JRavenelco/WRO_2025_SSbots/Engineering_Journal/August/IMG_20250806_161136889.jpg

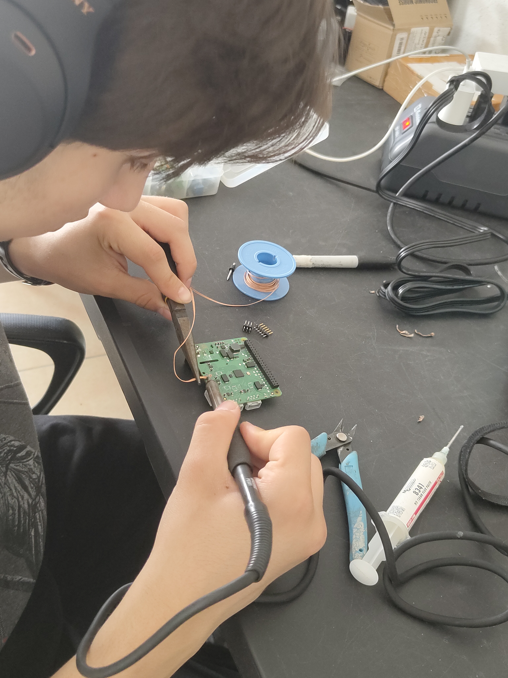
Engineering_Journal/August/IMG_20250806_161136889.jpg
