JRavenelco/WRO_2025_SSbots/models/README.md

# Models

This folder contains the various 3D printing files and models of the Robot LEGO chassis design. The design process and usage of these parts are documented in the [Hardware documentation](https://github.com/JRavenelco/WRO_2025_SSbots/tree/main/Engineering_Journal).
