JRavenelco/WRO_2025_SSbots/oak/README.md

This file contains the dataset used by the team to train the model for the camera to detect the various obstacles the robot will confront during the 2nd challenge.
