JRavenelco/WRO_2025_SSbots/lidar/README.md

This file contains usefull tools related to the LiDAR, this helped us a lot through the proccess of programming our robot.
