JRavenelco/WRO_2025_SSbots/v-photos/Render/README.md

# Vehicle's photos

This folder contains Renders of the CAD models and pictures of the current iteration of the robot, one from each direction, and its Hardware components.
