JRavenelco/WRO_2025_SSbots/videos/README.md

# Test and development videos

This folder contains videos of performance tests and of some of the development activities.

## SSbots reto 1 16 de septiembre 2025
Mira el Short (https://www.youtube.com/shorts/EhMzD_oaSlY)

## SSbots 15 de septiembre 2025
Mira el Short (https://www.youtube.com/shorts/7kQmQHDEUo0)

## 14 de septiembre SSbots 2025
Mira el Short (https://www.youtube.com/shorts/f8a6-zWJJuc)

## 11 de septiembre SSBots 2025
Mira el Short (https://www.youtube.com/shorts/gj_roj9W8ns)

## 18 de septiembre SSBOTS 2025
Mira el Short (https://www.youtube.com/shorts/k6APh_VoyJg)
