JRavenelco/WRO_2025_SSbots/other/Power delivery board/Power delivery Architecture.png

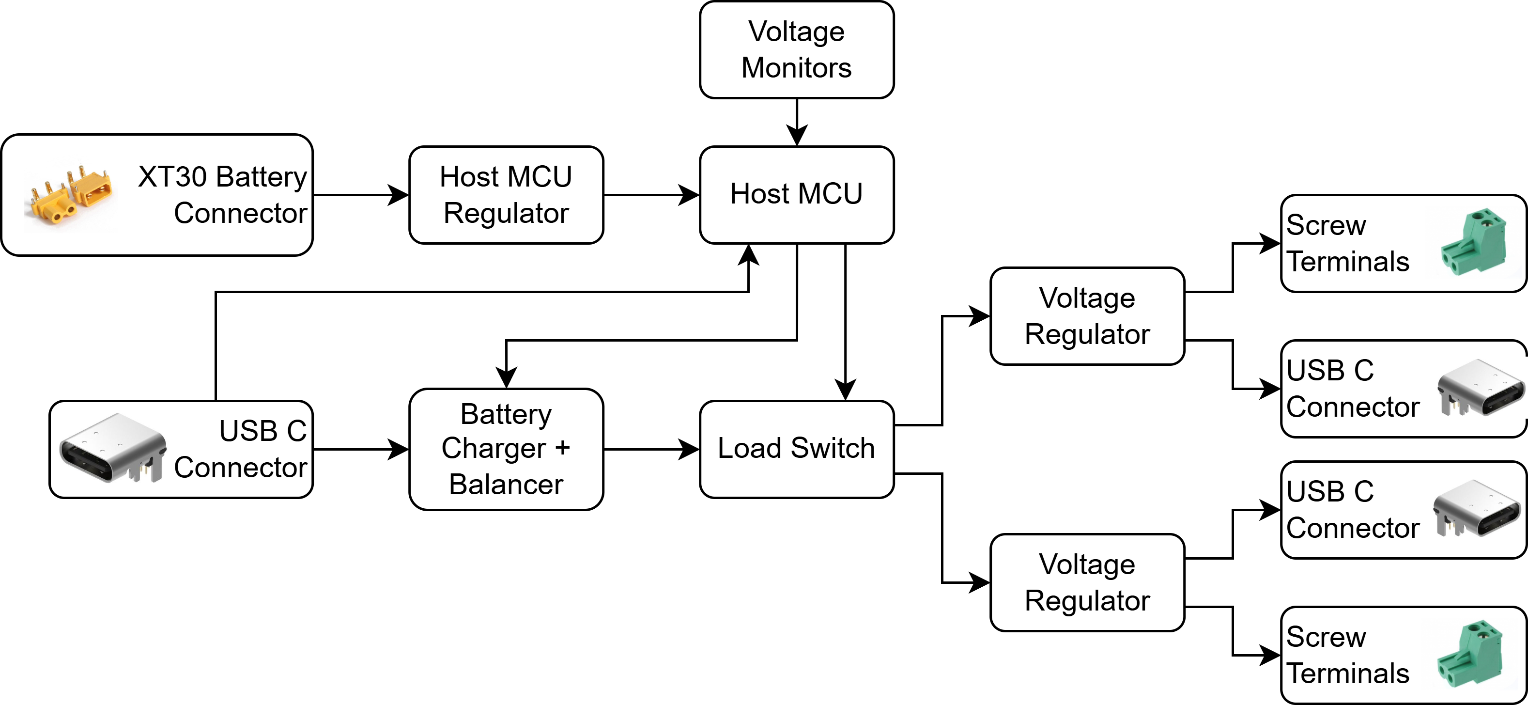
other/Power delivery board/Power delivery Architecture.png
