JRavenelco/WRO_2025_SSbots/other/Power Regulator Input.png

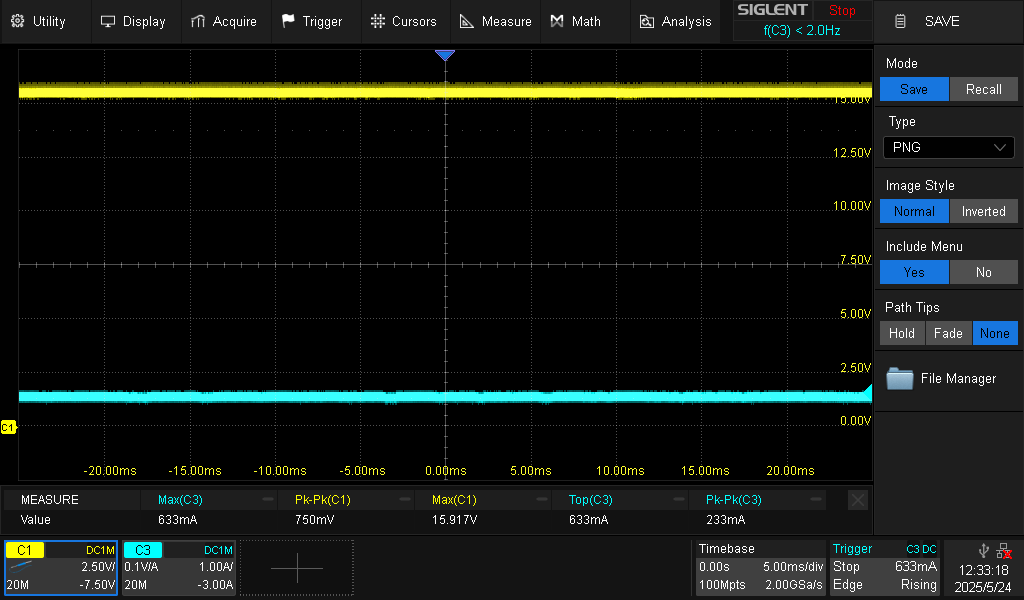
other/Power Regulator Input.png
