JRavenelco/WRO_2025_SSbots/other/Power Regulator Output.png

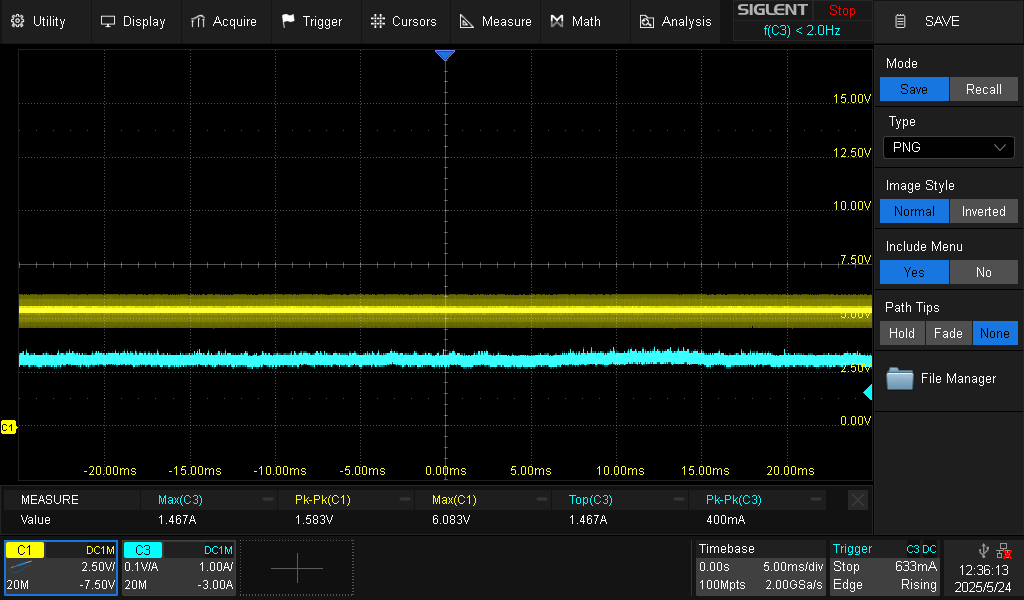
other/Power Regulator Output.png
