JRavenelco/WRO_2025_SSbots/t-photos/IMG_20250531_133741946.jpg

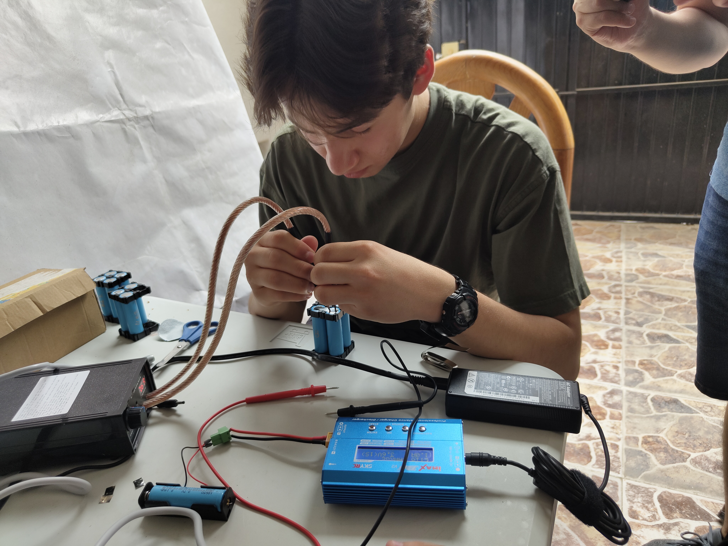
t-photos/IMG_20250531_133741946.jpg
