JRavenelco/WRO_2025_SSbots/v-photos/Back.jpg

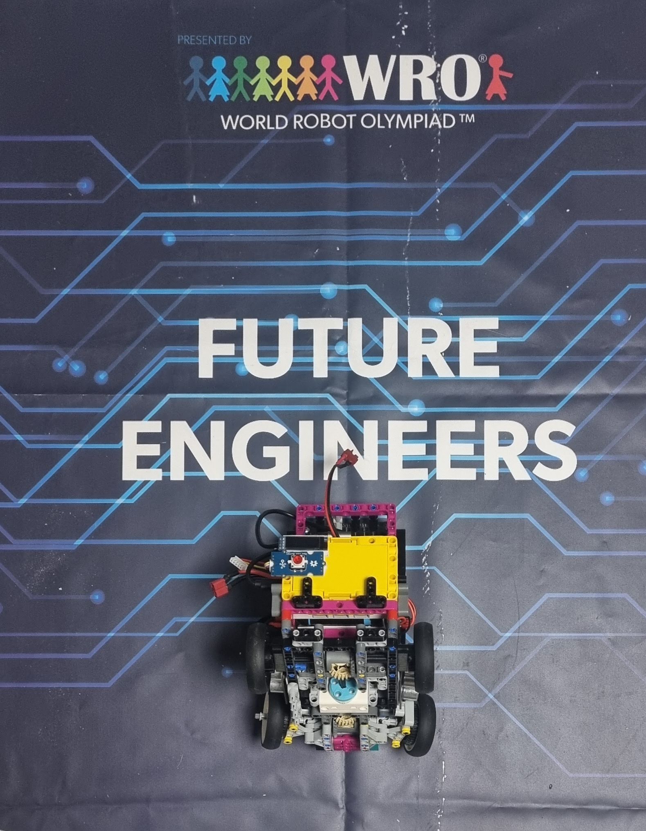
v-photos/Back.jpg
