JRavenelco/WRO_2025_SSbots/v-photos/Bottom.jpg

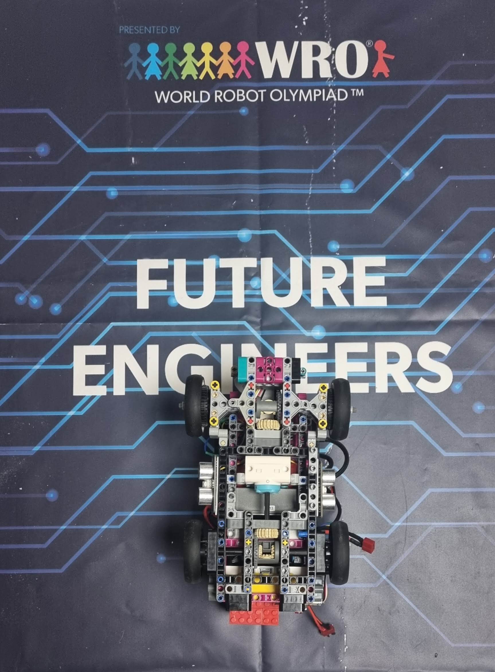
v-photos/Bottom.jpg
