JRavenelco/WRO_2025_SSbots/v-photos/Front.jpg

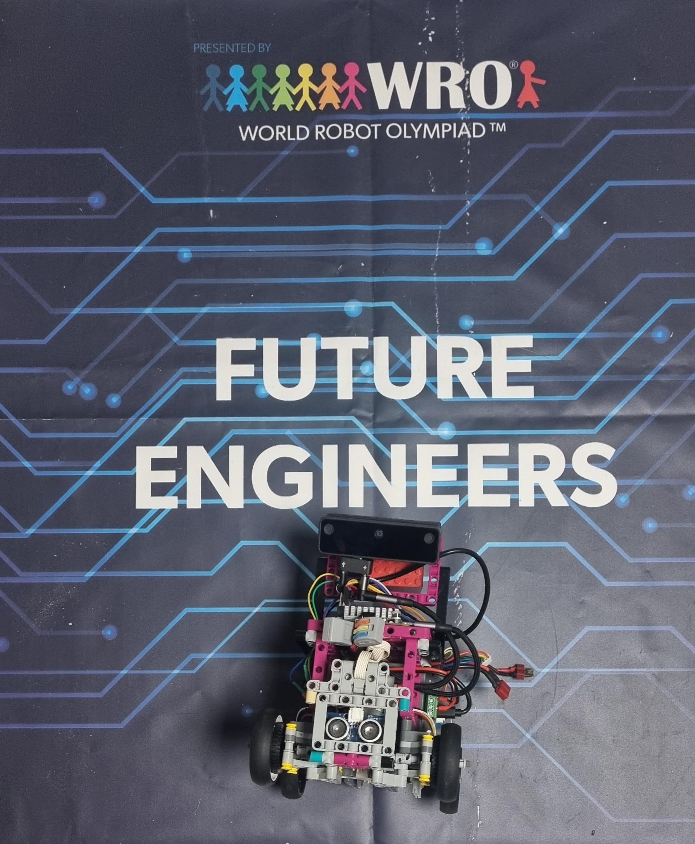
v-photos/Front.jpg
