JRavenelco/WRO_2025_SSbots/v-photos/Left.jpg

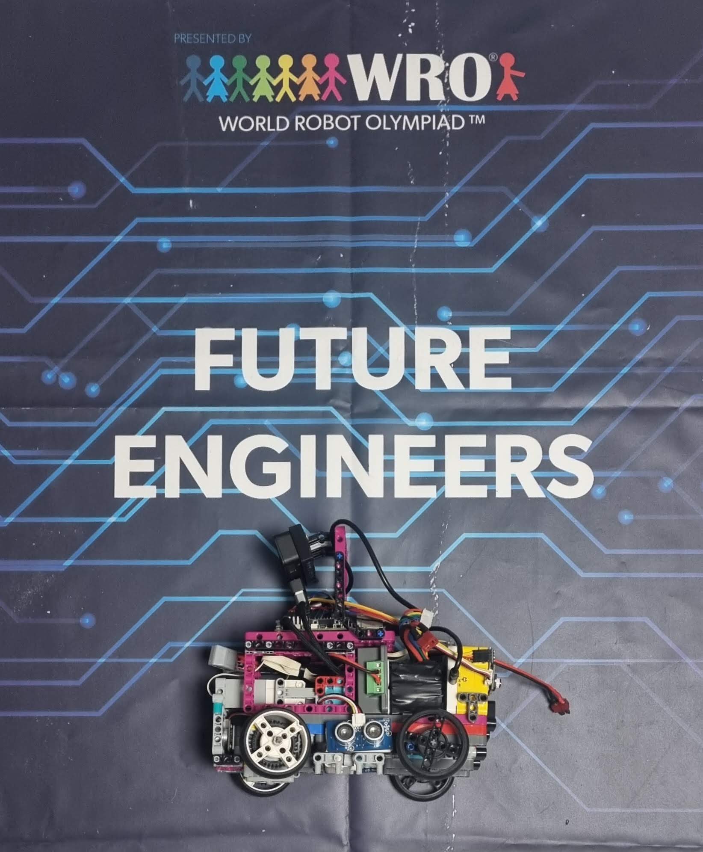
v-photos/Left.jpg
