JRavenelco/WRO_2025_SSbots/v-photos/Render/Back.png

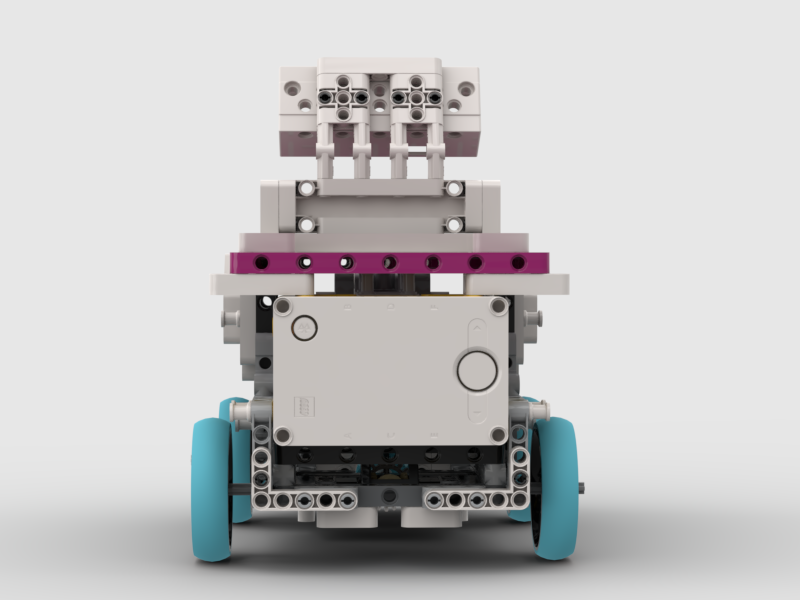
v-photos/Render/Back.png
