JRavenelco/WRO_2025_SSbots/v-photos/Render/Bottom.png

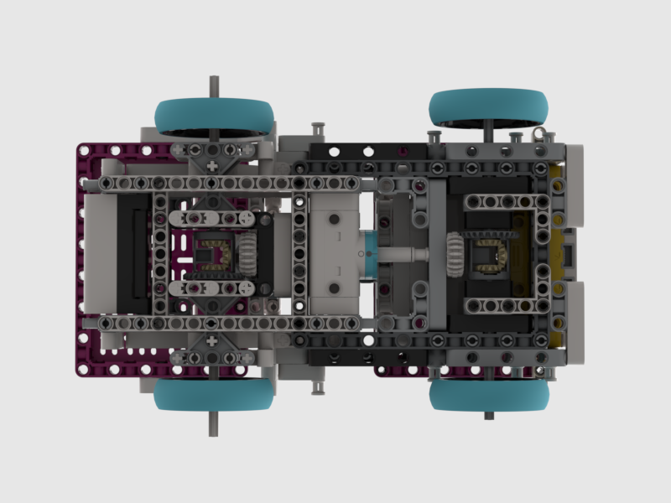
v-photos/Render/Bottom.png
