JRavenelco/WRO_2025_SSbots/v-photos/Render/Front.png

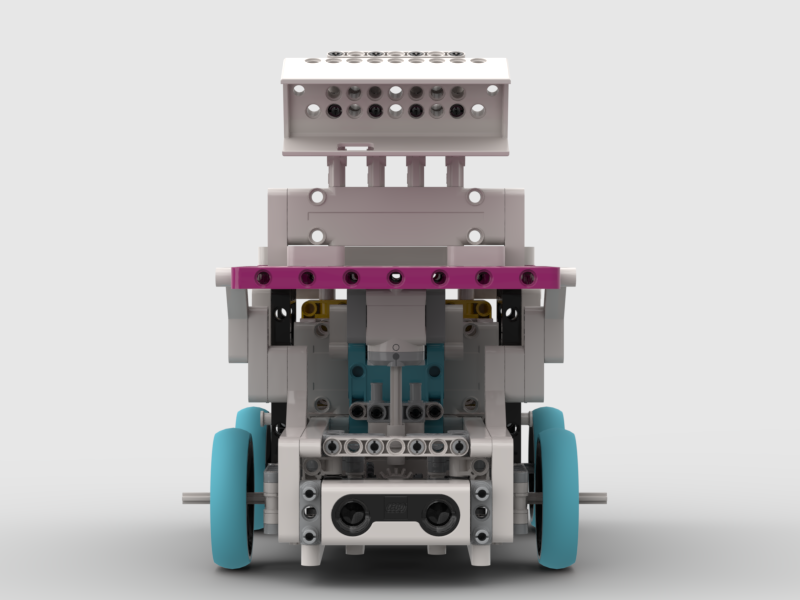
v-photos/Render/Front.png
