JRavenelco/WRO_2025_SSbots/v-photos/Render/Isometric.png

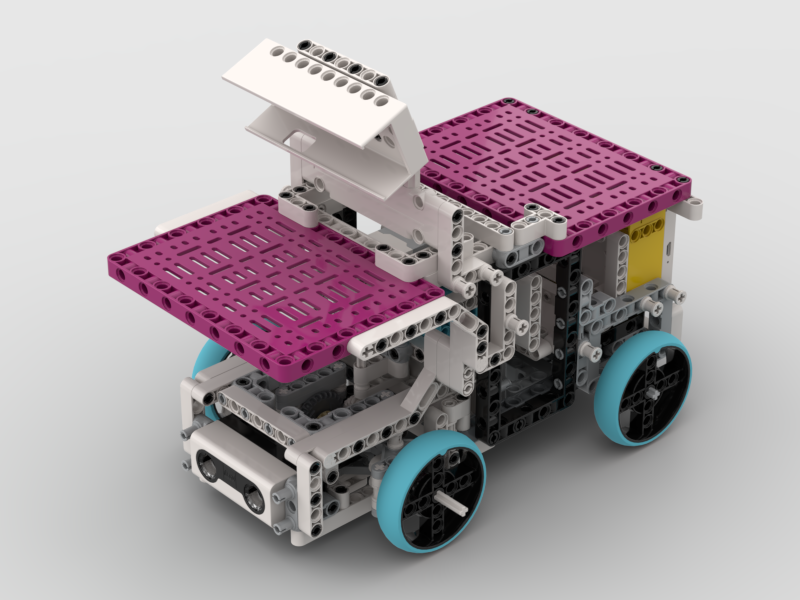
v-photos/Render/Isometric.png
