JRavenelco/WRO_2025_SSbots/v-photos/Render/Left.png

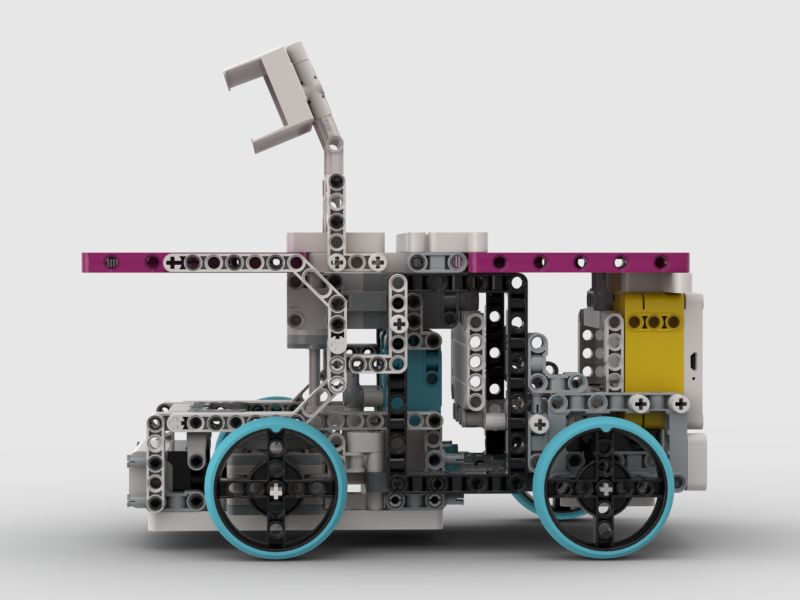
v-photos/Render/Left.png
