JRavenelco/WRO_2025_SSbots/v-photos/Render/Right.png

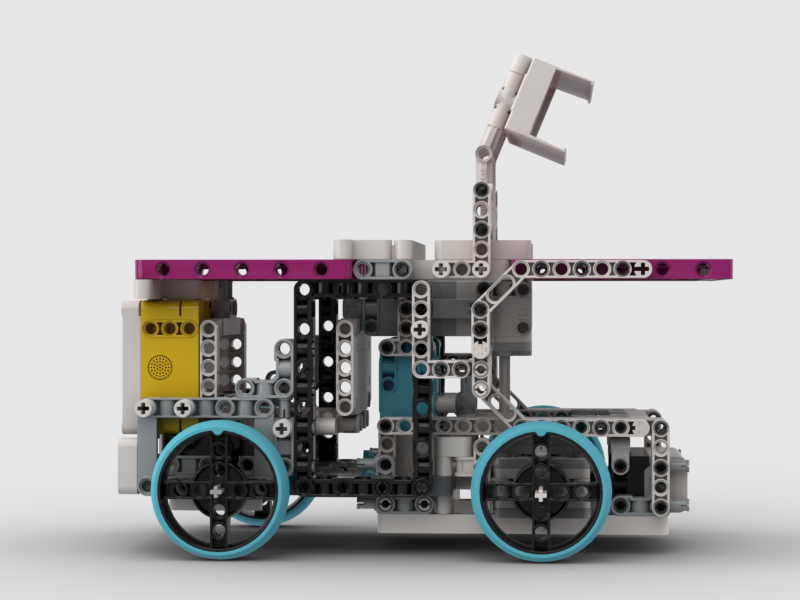
v-photos/Render/Right.png
