JRavenelco/WRO_2025_SSbots/v-photos/Render/Top.png

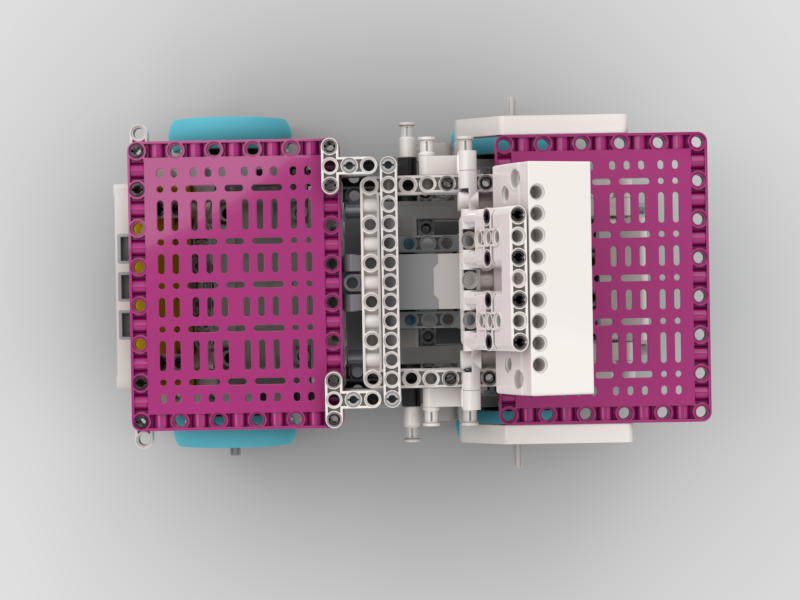
v-photos/Render/Top.png
