JRavenelco/WRO_2025_SSbots/v-photos/Right.jpg

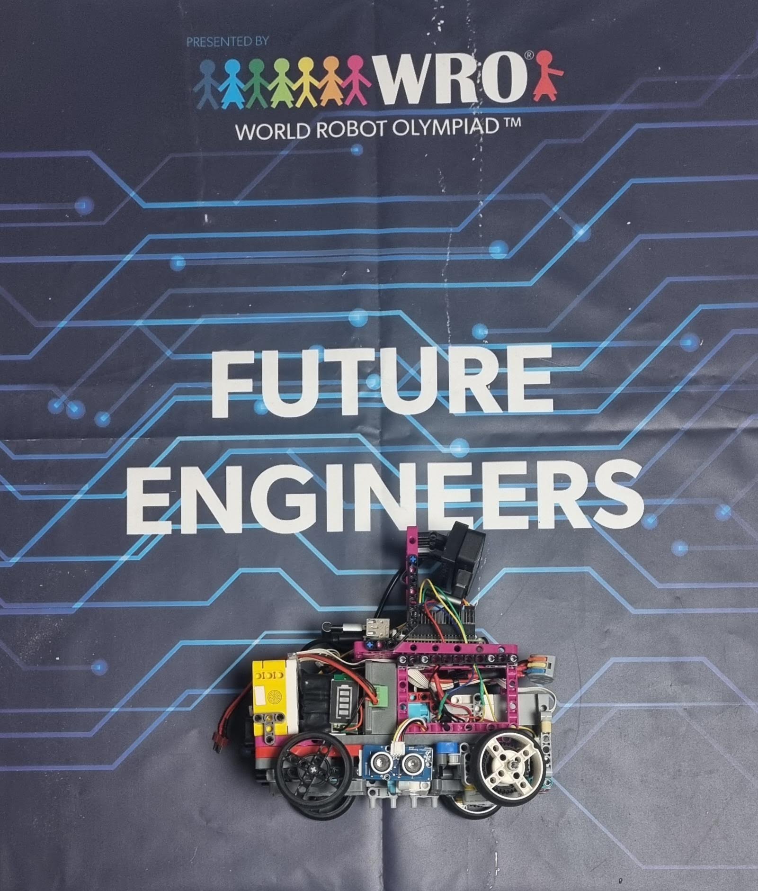
v-photos/Right.jpg
