JRavenelco/WRO_2025_SSbots/v-photos/Robot Nationals Ver (4).jpg

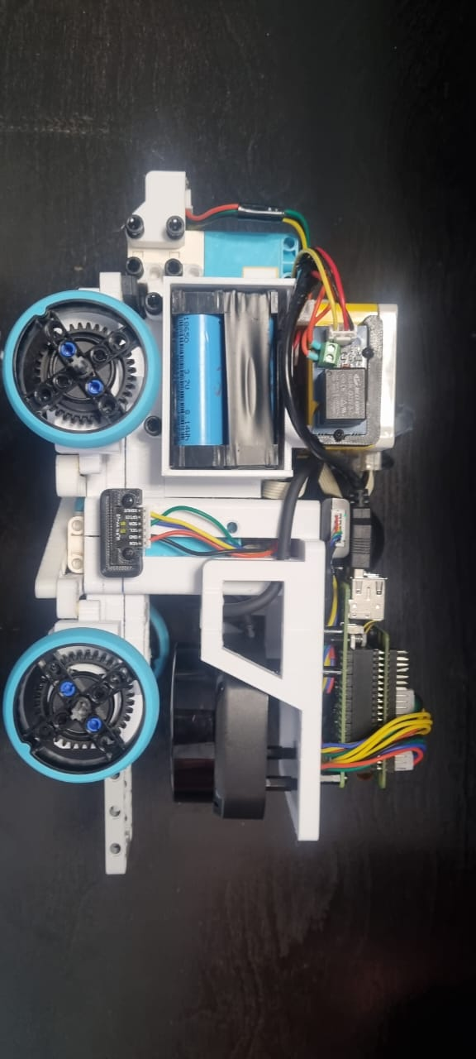
v-photos/Robot Nationals Ver (4).jpg
