JRavenelco/WRO_2025_SSbots/v-photos/Robot Nationals Ver (5).jpg

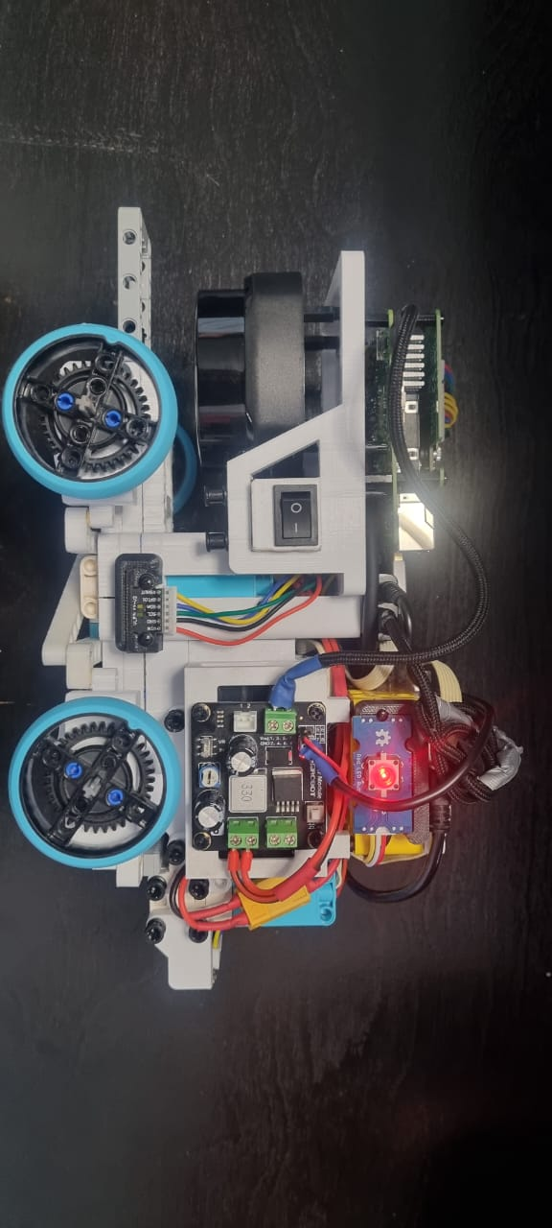
v-photos/Robot Nationals Ver (5).jpg
