JRavenelco/WRO_2025_SSbots/v-photos/Robot Nationals Ver (6).jpg

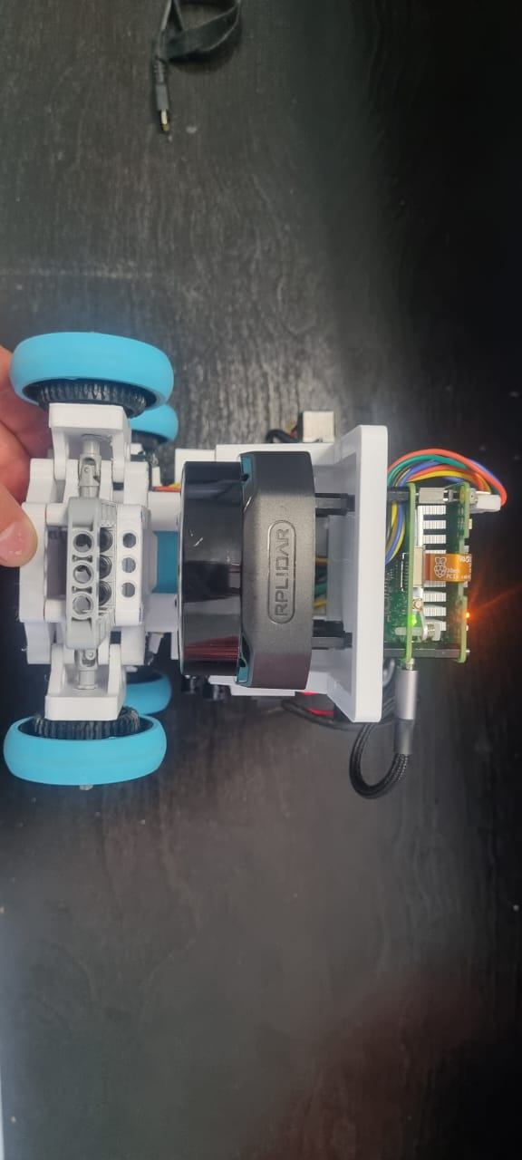
v-photos/Robot Nationals Ver (6).jpg
