JRavenelco/WRO_2025_SSbots/v-photos/Top.jpg

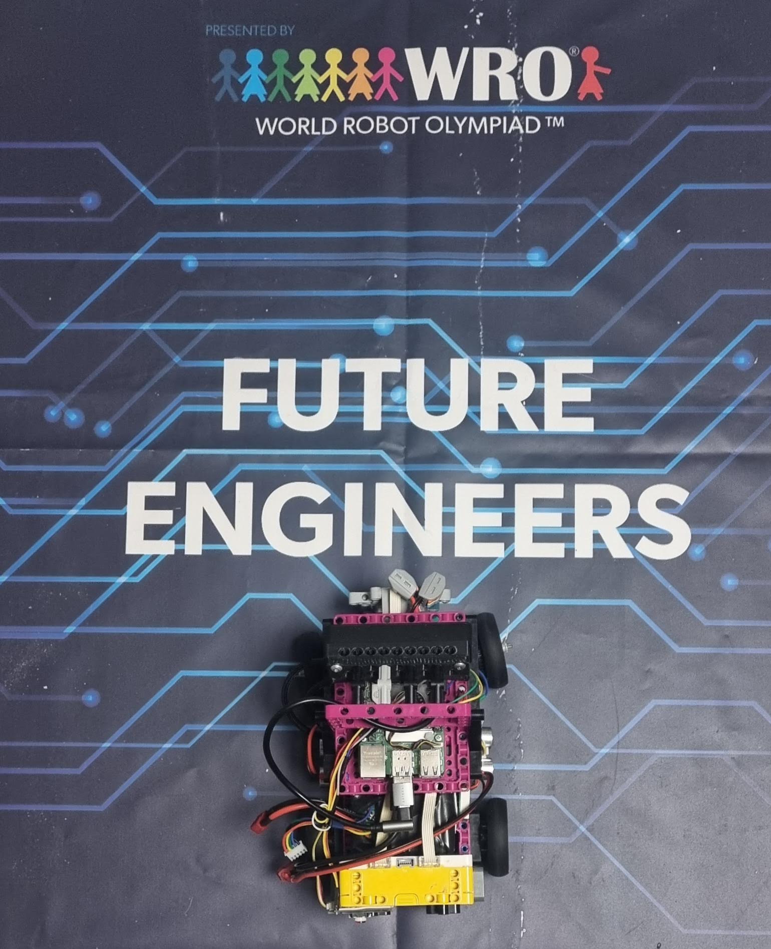
v-photos/Top.jpg
