JRavenelco/WRO_2025_SSbots/Engineering_Journal/August/Viga_LiDAR_prueba1.stl

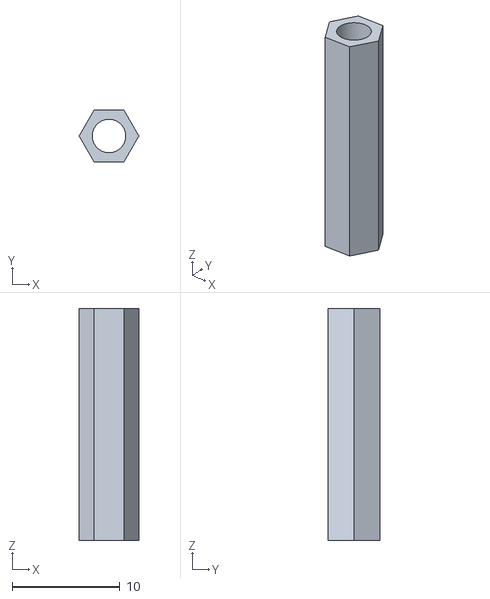
[picture p26: CAD file, 2025-08-16]
Engineering_Journal/August/Viga_LiDAR_prueba1.stl
5.54 x 4.80 x 21.5
