JRavenelco/WRO_2025_SSbots/models/beam_12_jellyfish.stl

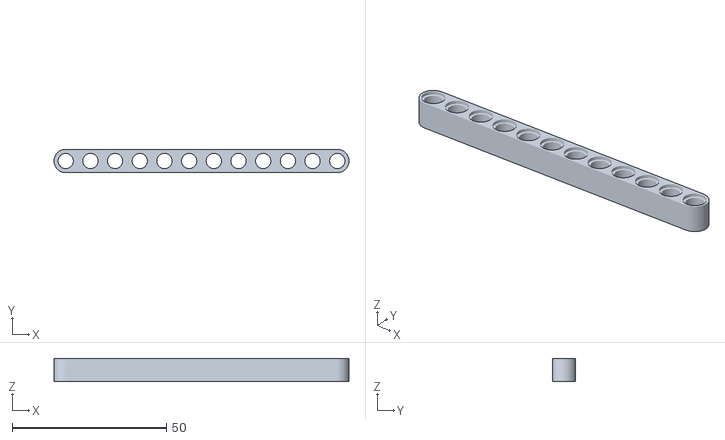
[picture p27: CAD file, 2025-09-17]
models/beam_12_jellyfish.stl
95.6 x 7.60 x 7.60
