JRavenelco/WRO_2025_SSbots/Engineering_Journal/August/Enclosure_pilas_-peso.stl

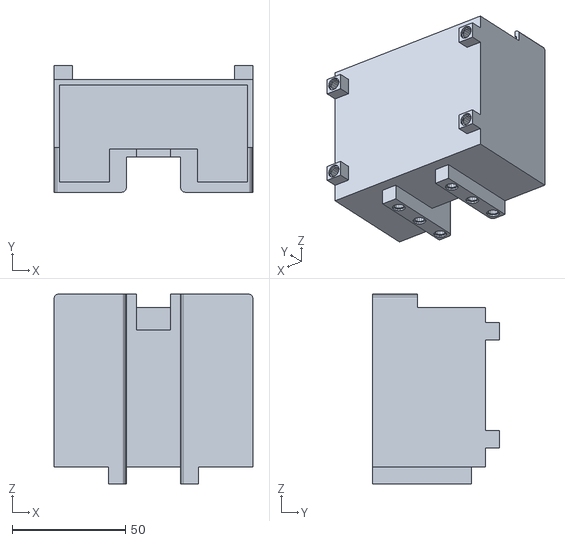
[picture p28: CAD file, 2025-08-16]
Engineering_Journal/August/Enclosure_pilas_-peso.stl
88.0 x 56.0 x 84.0
