JRavenelco/WRO_2025_SSbots/models/robot_rear_base_jellyfish.stl

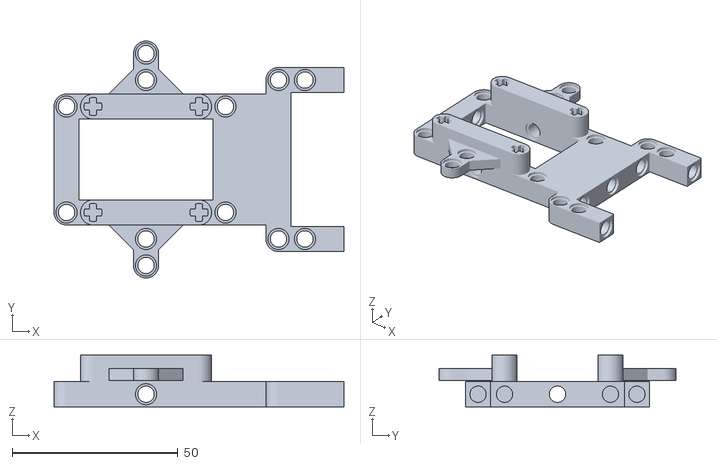
[picture p29: CAD file, 2025-09-17]
models/robot_rear_base_jellyfish.stl
87.6 x 71.6 x 15.6
