JRavenelco/WRO_2025_SSbots/Engineering_Journal/August/Base_sensor_atrás_prueba1.stl

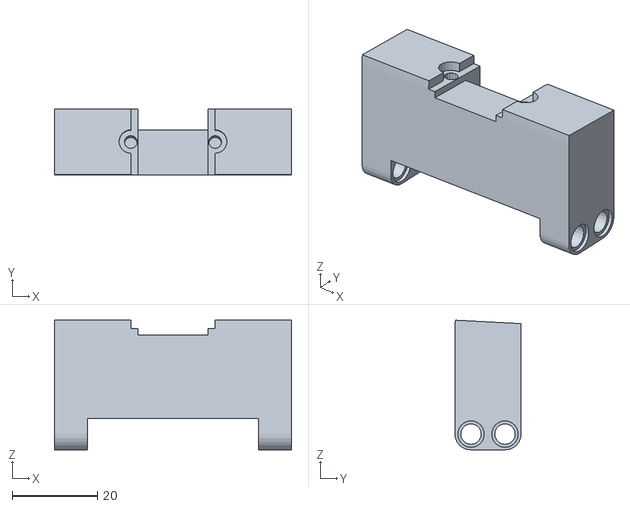
[picture p30: CAD file, 2025-08-12]
Engineering_Journal/August/Base_sensor_atrás_prueba1.stl
55.5 x 15.5 x 30.4
