JRavenelco/WRO_2025_SSbots/models/motor_chasis_jellyfish.stl

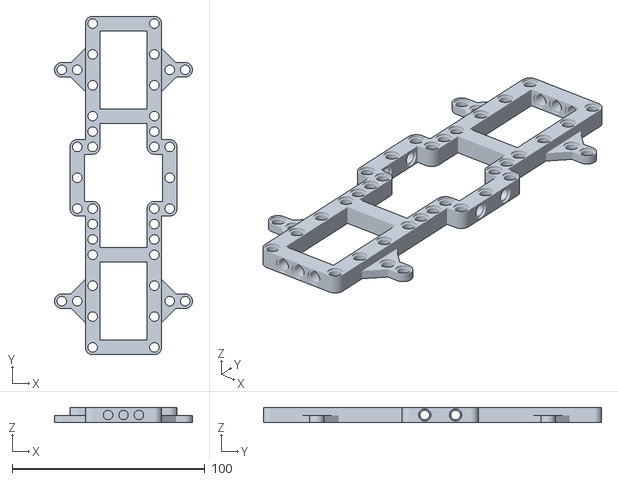
[picture p31: CAD file, 2025-09-17]
models/motor_chasis_jellyfish.stl
71.6 x 175.6 x 7.60
