JRavenelco/WRO_2025_SSbots/Engineering_Journal/August/Base_sensor_lateral_2.0_prueba2.stl

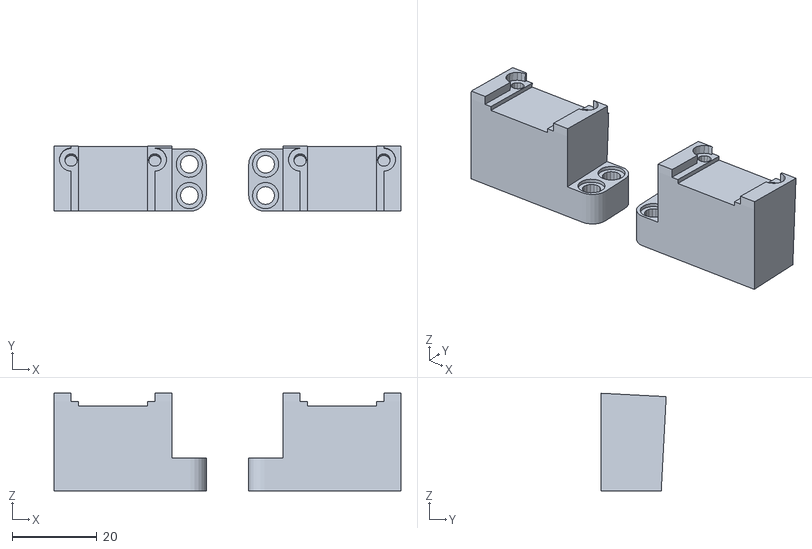
[picture p32: CAD file, 2025-08-12]
Engineering_Journal/August/Base_sensor_lateral_2.0_prueba2.stl
81.8 x 15.4 x 23.0
