JRavenelco/WRO_2025_SSbots/models/beam_11x2_jellyfish.stl

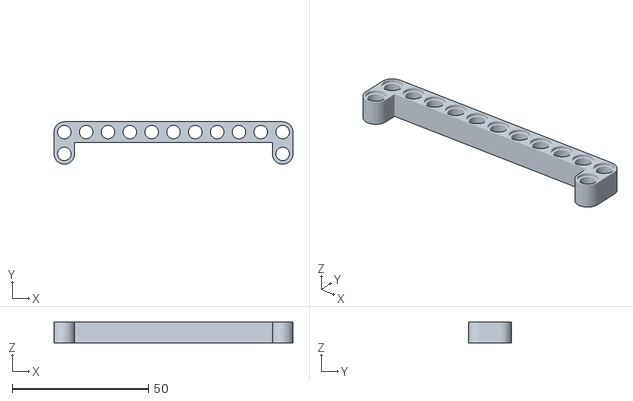
[picture p33: CAD file, 2025-09-17]
models/beam_11x2_jellyfish.stl
87.6 x 15.6 x 7.60
