JRavenelco/WRO_2025_SSbots/Engineering_Journal/August/Enclosure_pilas_3.0.stl

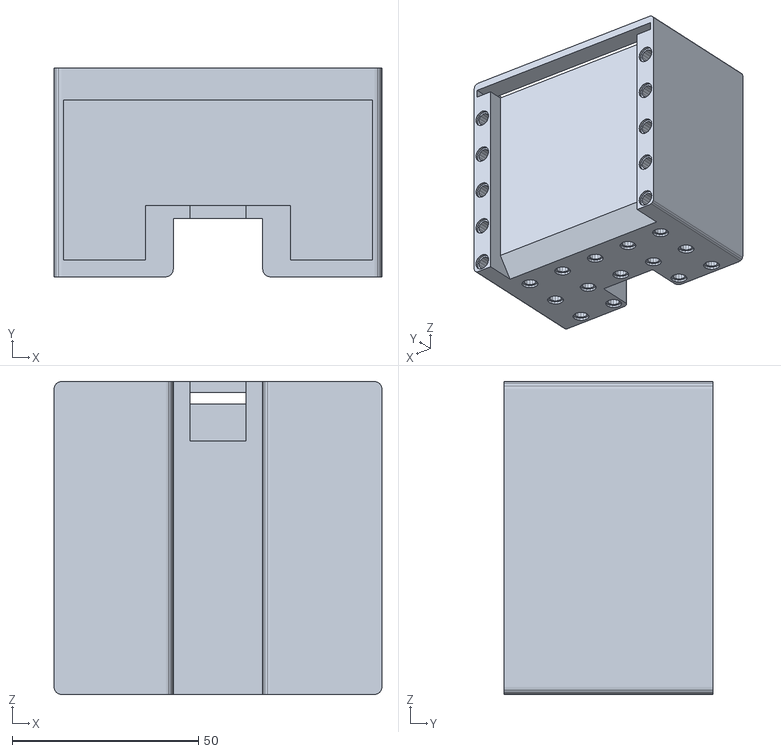
[picture p34: CAD file, 2025-08-12]
Engineering_Journal/August/Enclosure_pilas_3.0.stl
88.0 x 56.0 x 84.0
