JRavenelco/WRO_2025_SSbots/models/axle_support_rear_jellyfish.stl

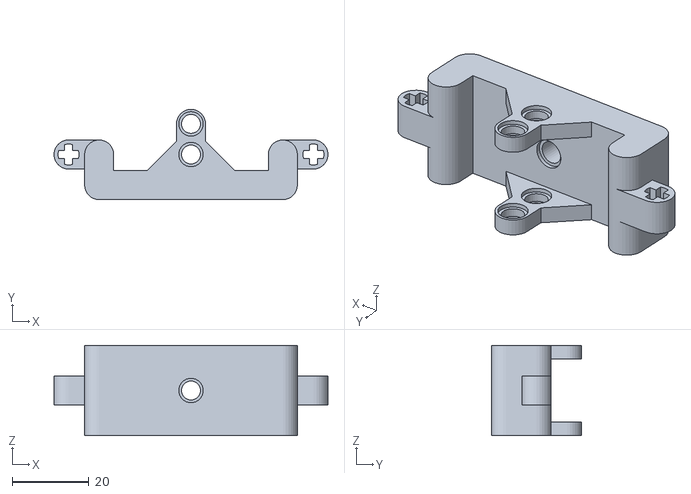
[picture p35: CAD file, 2025-09-17]
models/axle_support_rear_jellyfish.stl
71.6 x 23.6 x 23.6
