JRavenelco/WRO_2025_SSbots/Engineering_Journal/August/Tapa_enclosure_pilas_2.0.stl

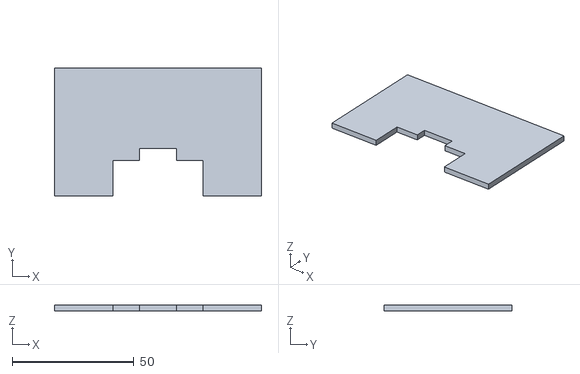
[picture p36: CAD file, 2025-08-07]
Engineering_Journal/August/Tapa_enclosure_pilas_2.0.stl
85.0 x 52.5 x 2.50
