JRavenelco/WRO_2025_SSbots/models/gearRack_beam_jellyfish.stl

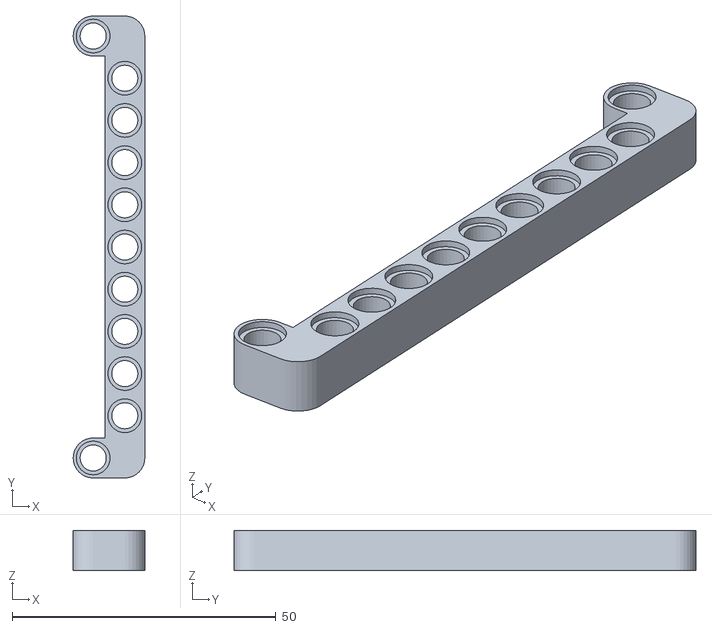
[picture p37: CAD file, 2025-09-17]
models/gearRack_beam_jellyfish.stl
13.6 x 87.6 x 7.60
