JRavenelco/WRO_2025_SSbots/Engineering_Journal/August/Enclosure_pilas.stl

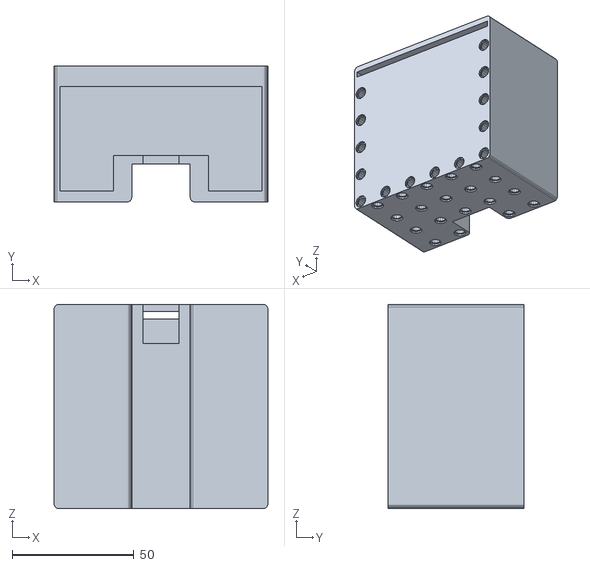
[picture p38: CAD file, 2025-08-07]
Engineering_Journal/August/Enclosure_pilas.stl
88.0 x 56.0 x 84.0
