JRavenelco/WRO_2025_SSbots/models/axle_support_front_jellyfish.stl

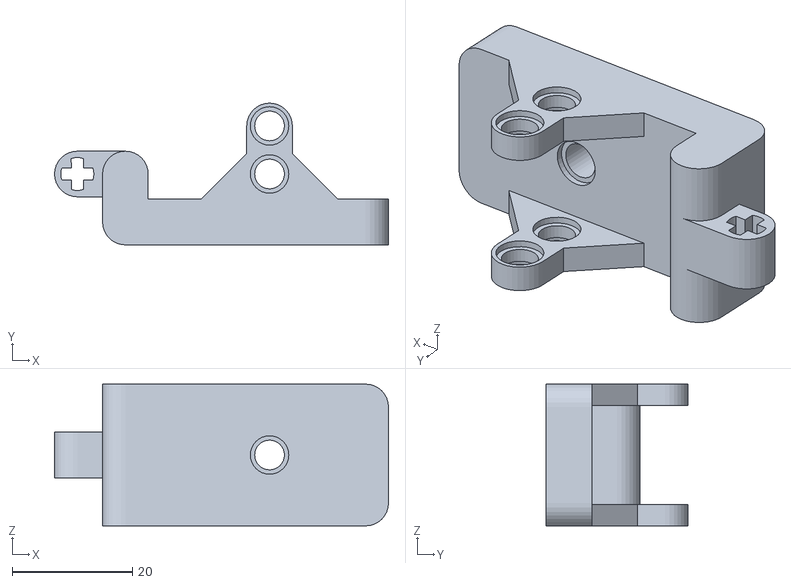
[picture p39: CAD file, 2025-09-17]
models/axle_support_front_jellyfish.stl
55.6 x 23.6 x 23.6
