JRavenelco/WRO_2025_SSbots/models/monstrosity_jellyfish.stl

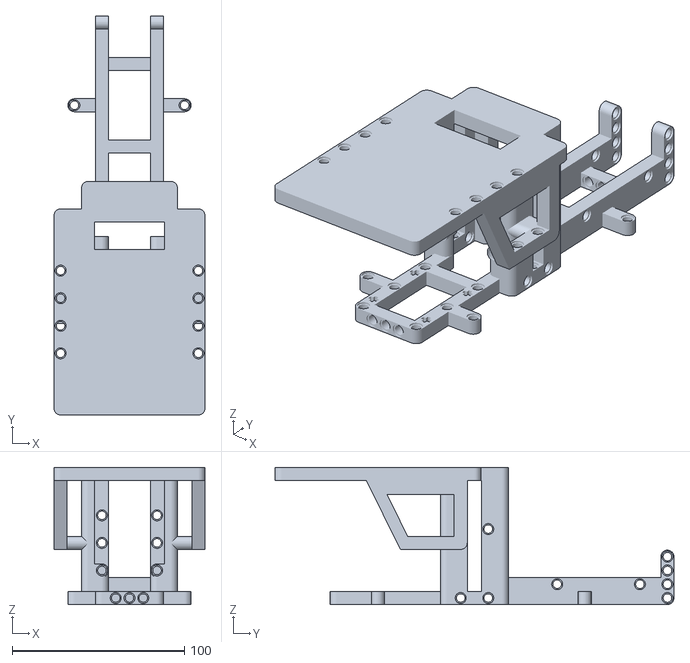
[picture p40: CAD file, 2025-09-17]
models/monstrosity_jellyfish.stl
87.6 x 231.6 x 79.6
