JRavenelco/WRO_2025_SSbots/models/backSensor_jellyfish.stl

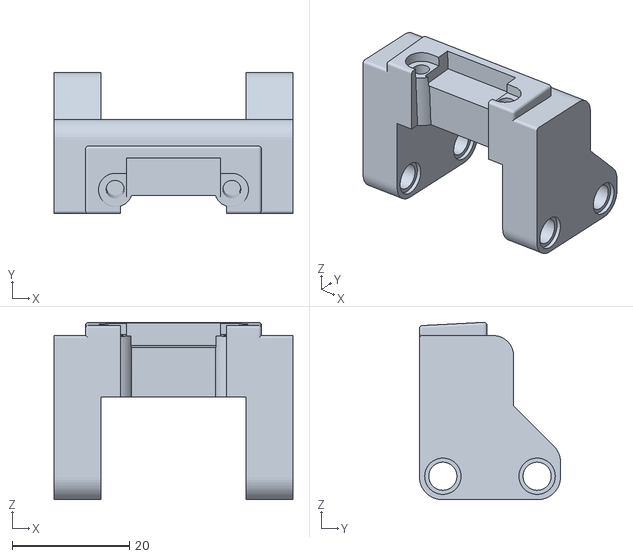
[picture p41: CAD file, 2025-09-17]
models/backSensor_jellyfish.stl
40.8 x 24.1 x 30.3
