JRavenelco/WRO_2025_SSbots/models/tapa_enclosure_jellyfish.stl

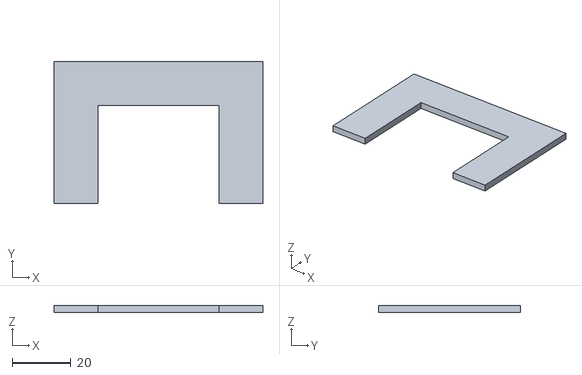
[picture p42: CAD file, 2025-09-17]
models/tapa_enclosure_jellyfish.stl
71.0 x 48.4 x 2.50
