JRavenelco/WRO_2025_SSbots/models/enclosure_pilas_jellyfish.stl

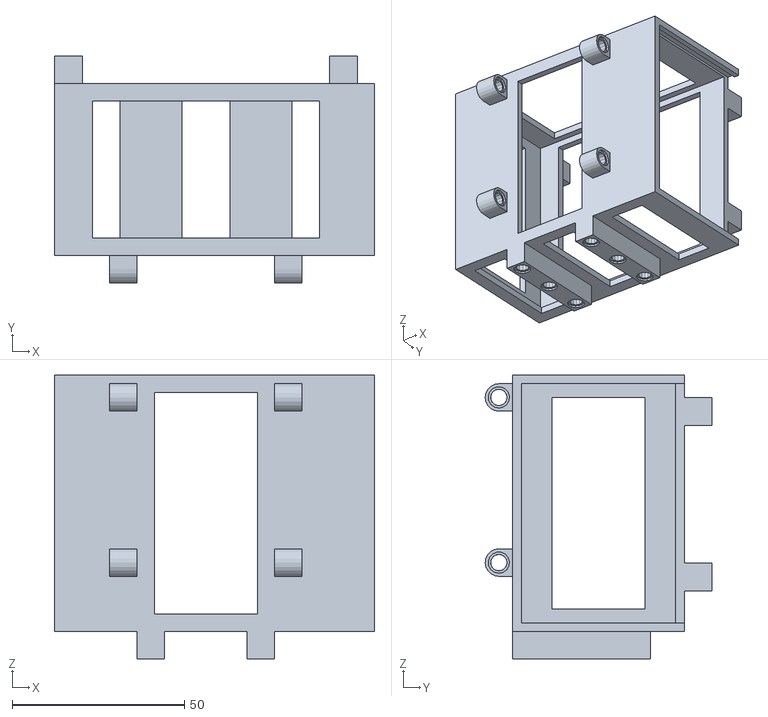
[picture p43: CAD file, 2025-09-17]
models/enclosure_pilas_jellyfish.stl
93.0 x 65.9 x 82.5
