JRavenelco/WRO_2025_SSbots/models/grooveBase_B_jellyfish.stl

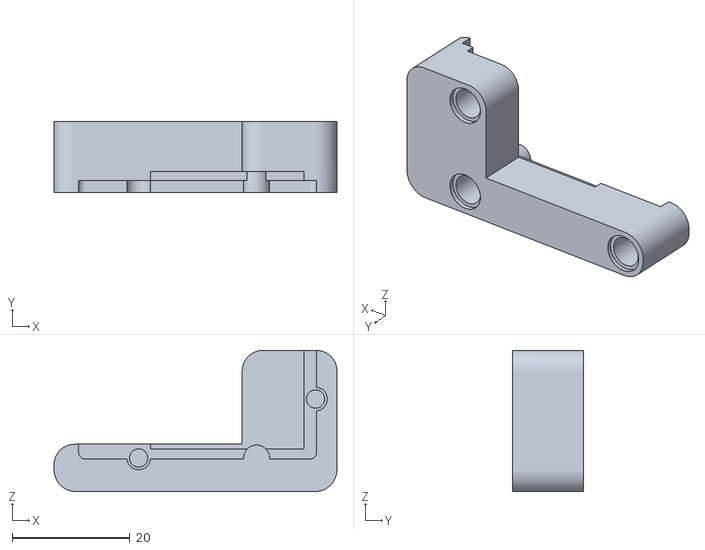
[picture p44: CAD file, 2025-08-16]
models/grooveBase_B_jellyfish.stl
48.0 x 12.0 x 24.0
