JRavenelco/WRO_2025_SSbots/models/rightSensor_jellyfish.stl

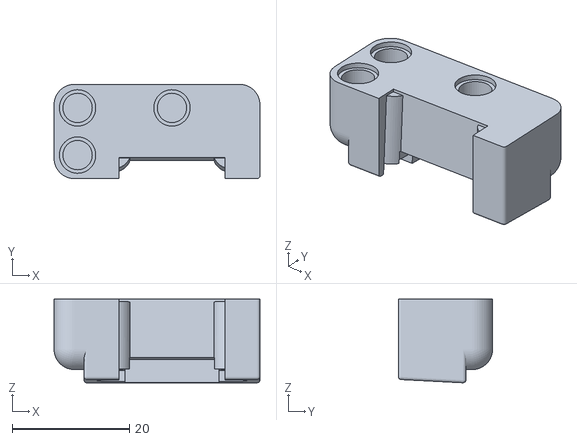
[picture p45: CAD file, 2025-08-16]
models/rightSensor_jellyfish.stl
35.1 x 16.1 x 14.3
