JRavenelco/WRO_2025_SSbots/models/switchBase_jellyfish.stl

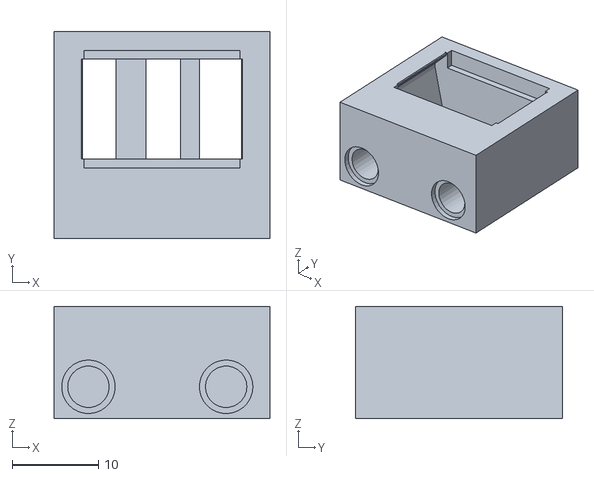
[picture p46: CAD file, 2025-08-12]
models/switchBase_jellyfish.stl
25.0 x 24.0 x 13.0
