JRavenelco/WRO_2025_SSbots/models/OAK camera mount.stl

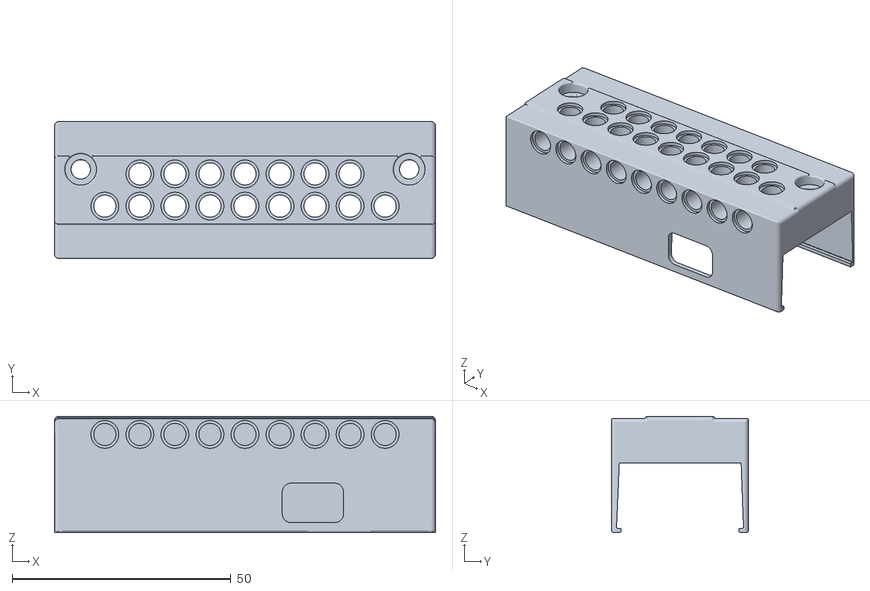
[picture p47: CAD file, 2025-06-27]
models/OAK camera mount.stl
87.0 x 31.3 x 26.6
