JRavenelco/WRO_2025_SSbots/(list of files, cad)

Other CAD files:
models/robot_front_base_jellyfish.stl
models/leftSensor_jellyfish.stl
models/grooveBase_A_jellyfish.stl
