JRavenelco/WRO_2025_SSbots/schemes/Wiring Diagram Nationals.png

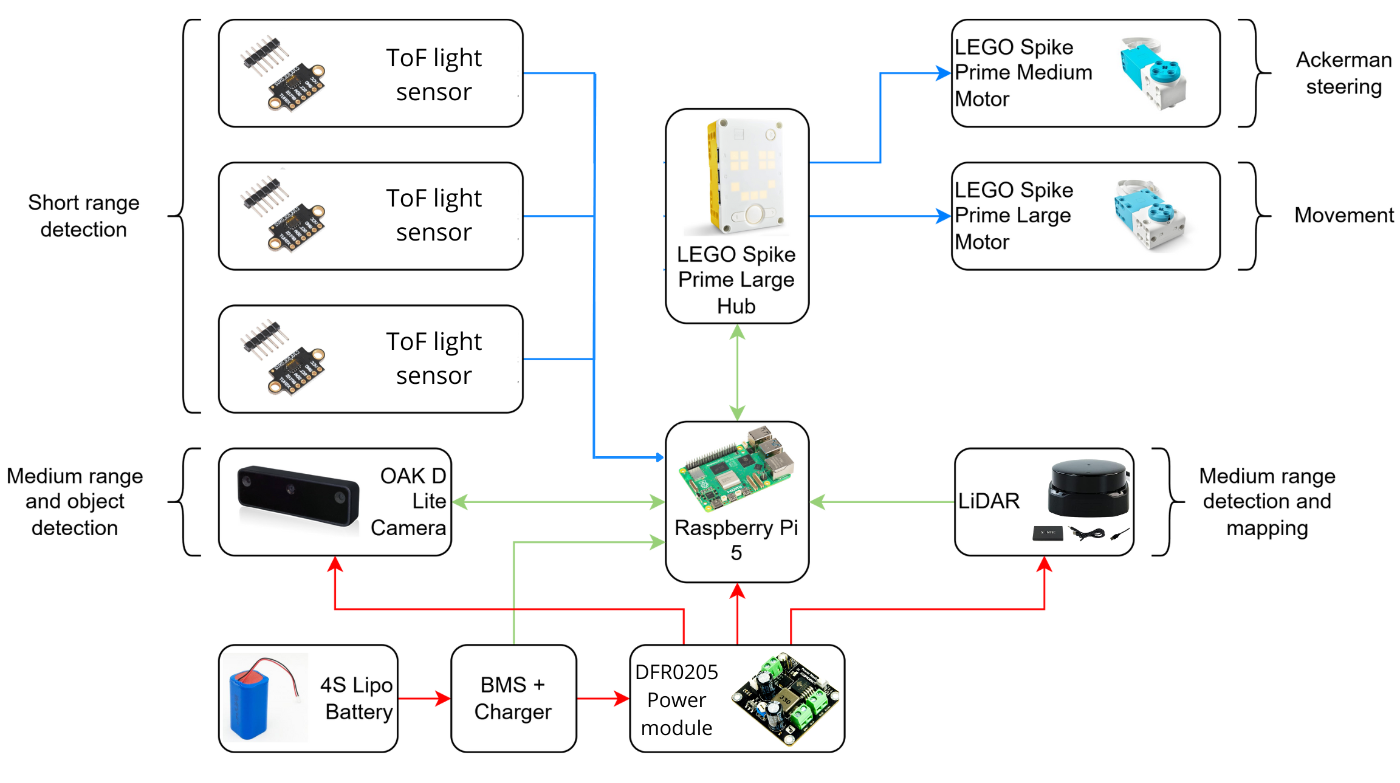
schemes/Wiring Diagram Nationals.png
