JRavenelco/WRO_2025_SSbots/schemes/Wiring Diagram Regionals.png

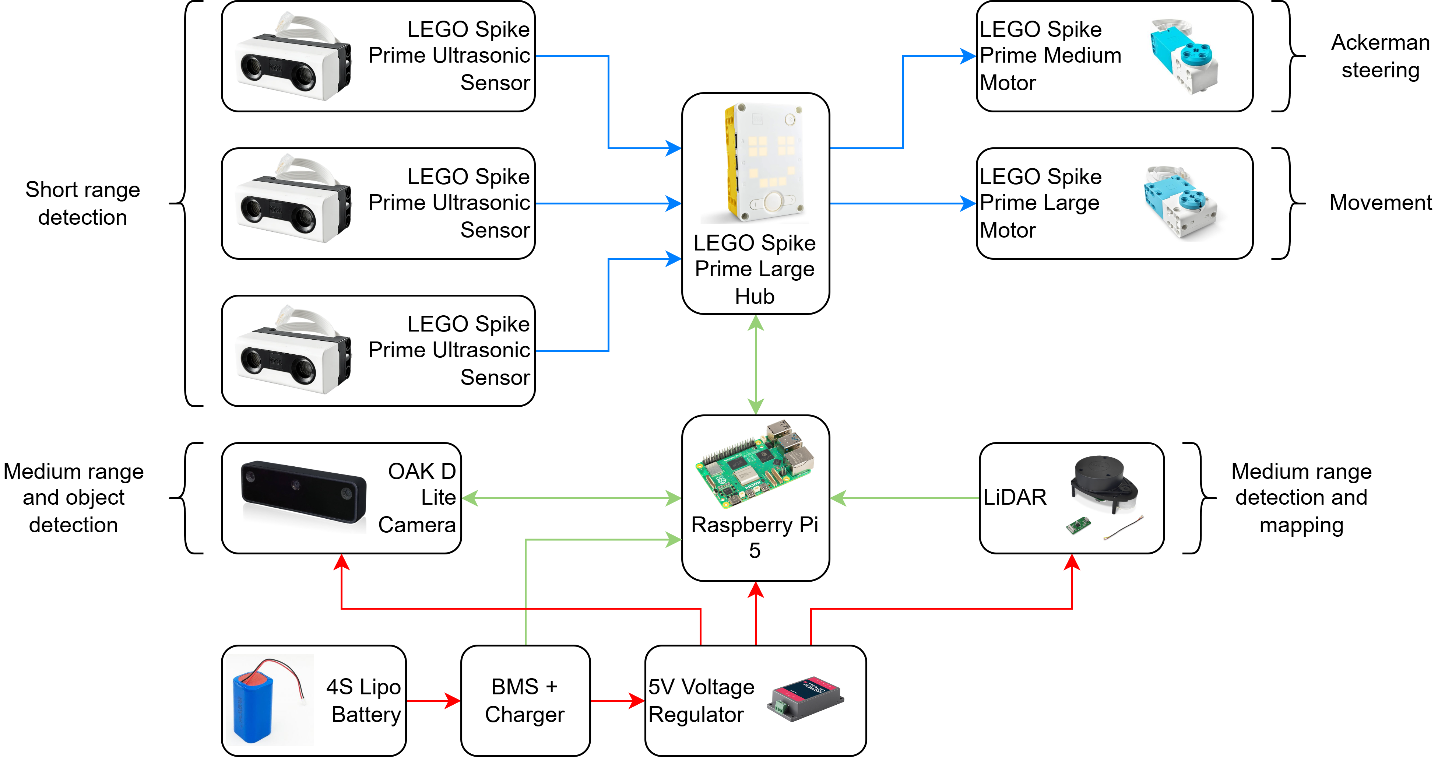
schemes/Wiring Diagram Regionals.png
