JRavenelco/WRO_2025_SSbots/Engineering_Journal/August/IMG_20250811_201526950.jpg

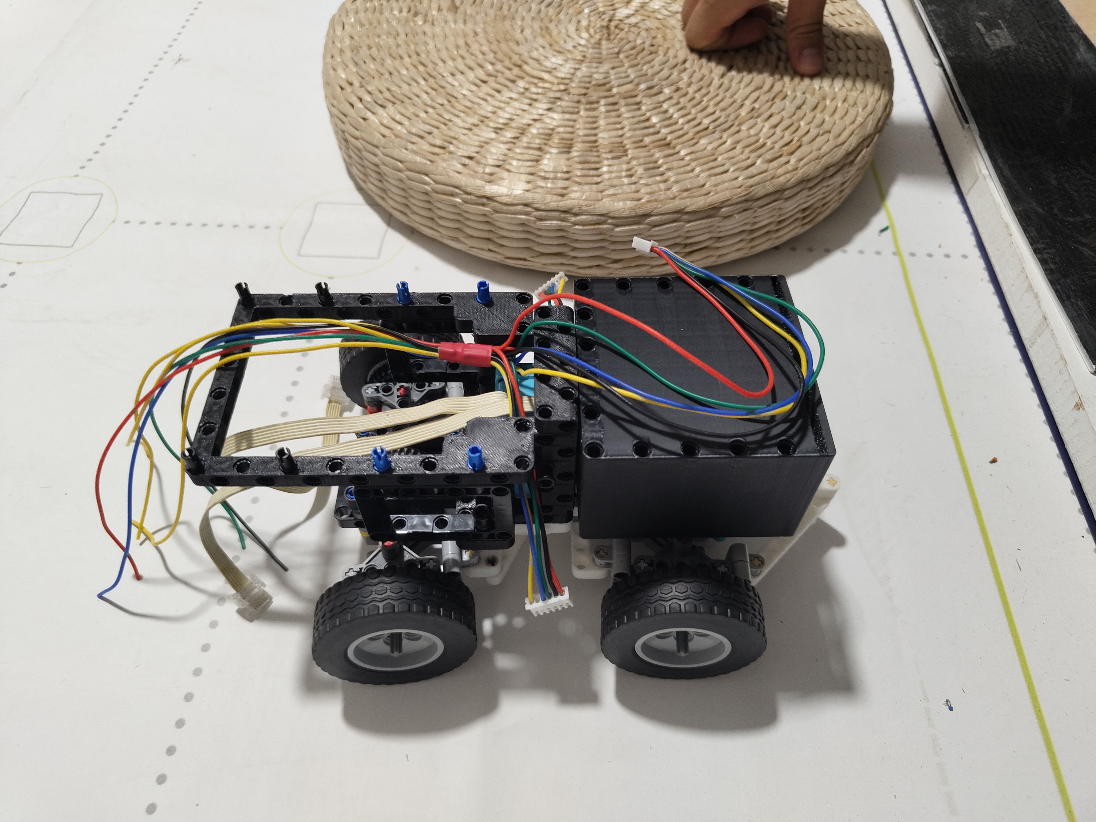
Engineering_Journal/August/IMG_20250811_201526950.jpg
