JRavenelco/WRO_2025_SSbots/Engineering_Journal/August/IMG_20250812_170013186.jpg

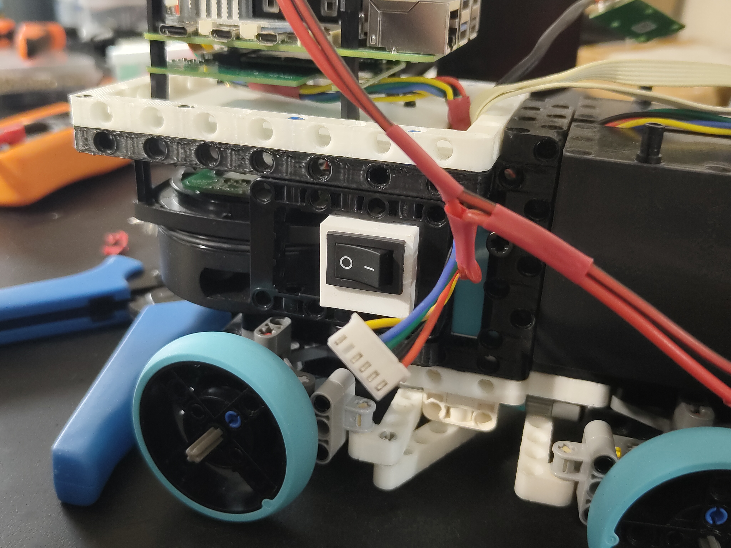
Engineering_Journal/August/IMG_20250812_170013186.jpg
