JRavenelco/WRO_2025_SSbots/Engineering_Journal/August/IMG_20250812_170212607.jpg

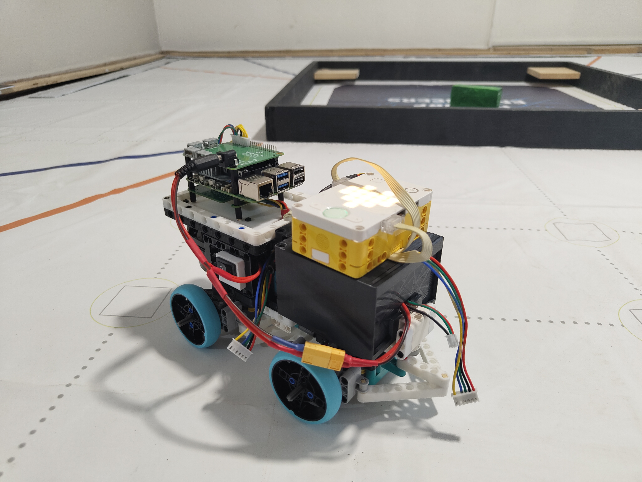
Engineering_Journal/August/IMG_20250812_170212607.jpg
