JRavenelco/WRO_2025_SSbots/Engineering_Journal/August/IMG_20250812_170215730.jpg

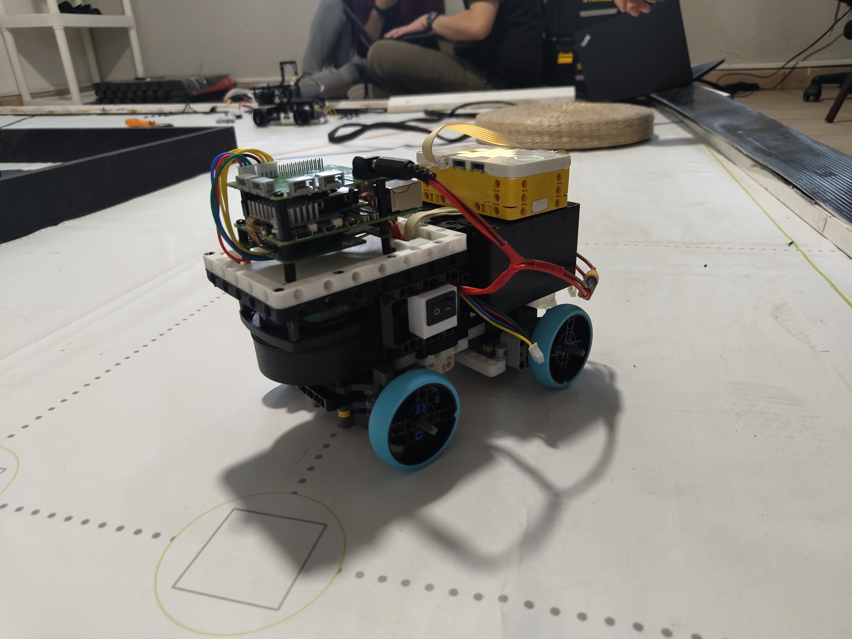
Engineering_Journal/August/IMG_20250812_170215730.jpg
