JRavenelco/WRO_2025_SSbots/Engineering_Journal/August/IMG_20250816_133144047.jpg

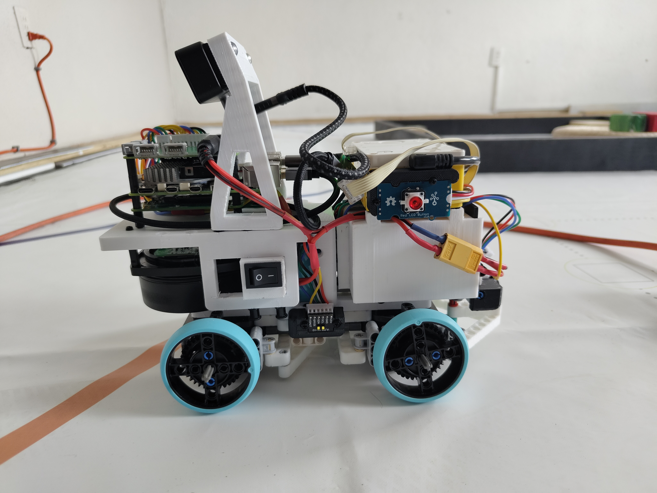
Engineering_Journal/August/IMG_20250816_133144047.jpg
