JRavenelco/WRO_2025_SSbots/Engineering_Journal/August/IMG_20250816_133158120.jpg

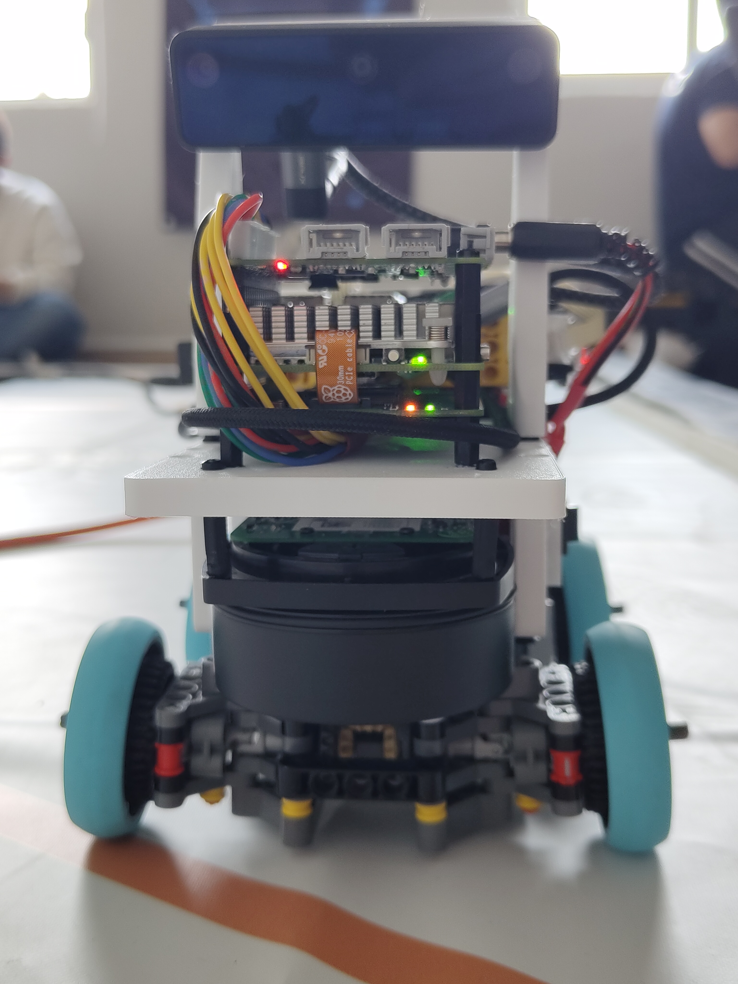
Engineering_Journal/August/IMG_20250816_133158120.jpg
