JRavenelco/WRO_2025_SSbots/Engineering_Journal/August/IMG_20250816_133215793.jpg

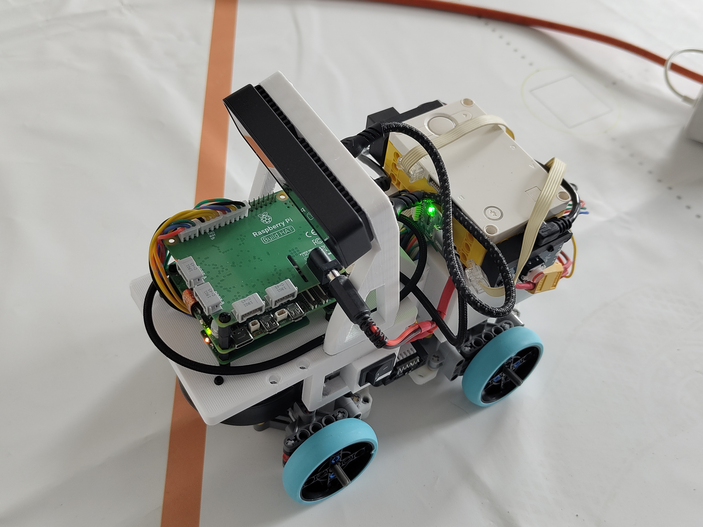
Engineering_Journal/August/IMG_20250816_133215793.jpg
