JRavenelco/WRO_2025_SSbots/Engineering_Journal/August/IMG_20250816_133219189.jpg

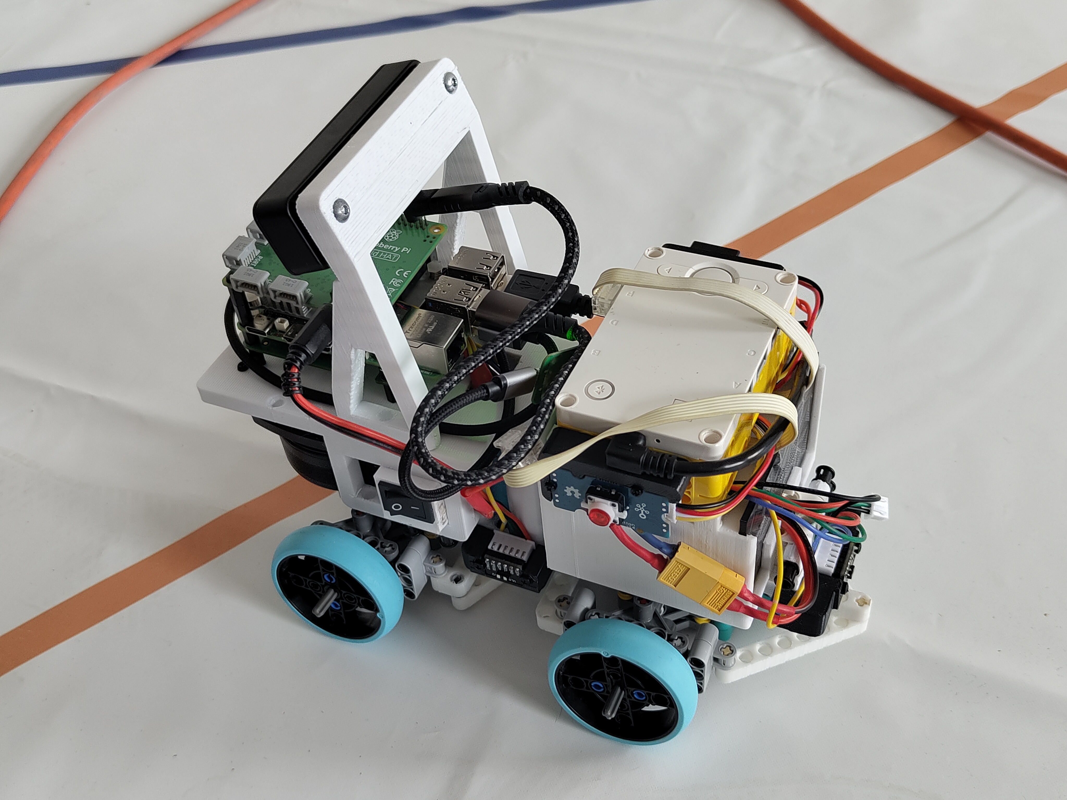
Engineering_Journal/August/IMG_20250816_133219189.jpg
