JRavenelco/WRO_2025_SSbots/Engineering_Journal/July/IMG_20250715_171318605 (1).jpg

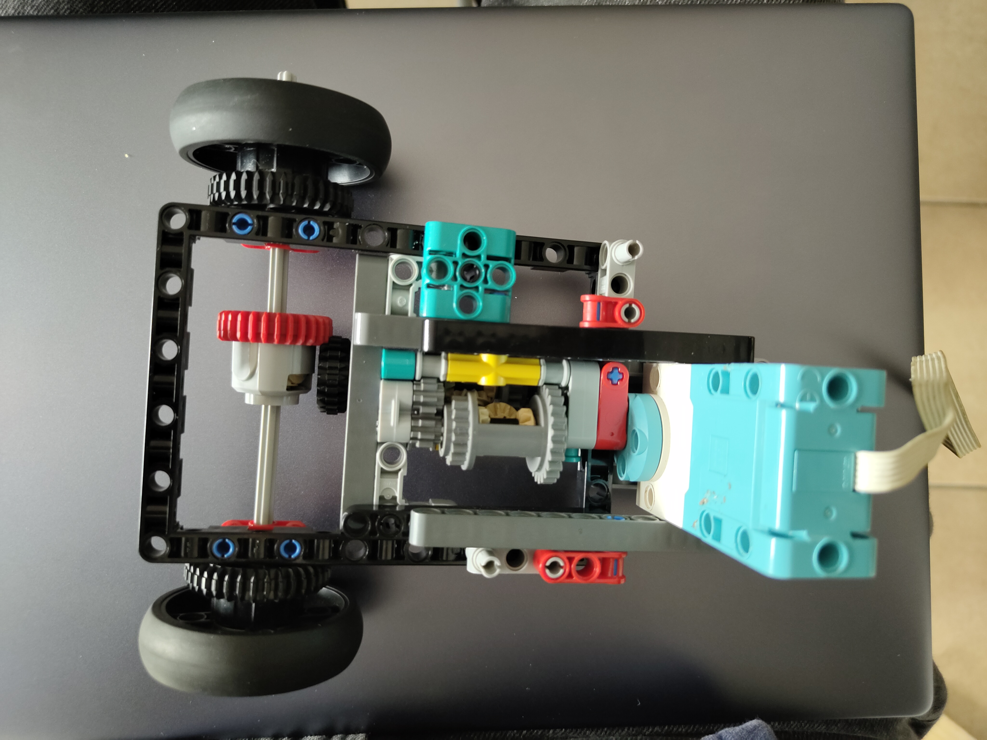
Engineering_Journal/July/IMG_20250715_171318605 (1).jpg
