JRavenelco/WRO_2025_SSbots/Engineering_Journal/July/IMG_20250715_171328529 (1).jpg

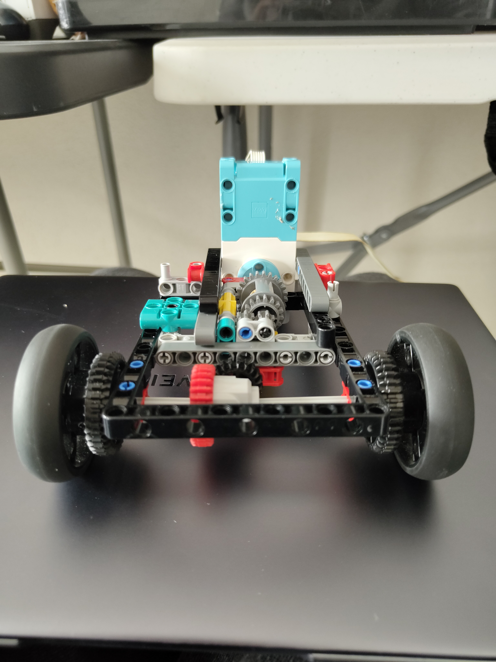
Engineering_Journal/July/IMG_20250715_171328529 (1).jpg
