JRavenelco/WRO_2025_SSbots/Engineering_Journal/July/IMG_20250724_155019106.jpg

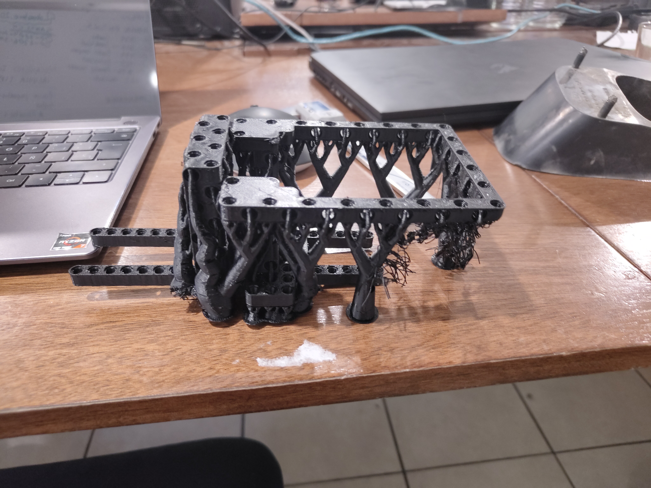
Engineering_Journal/July/IMG_20250724_155019106.jpg
