JRavenelco/WRO_2025_SSbots/Engineering_Journal/July/IMG_20250724_174622743.jpg

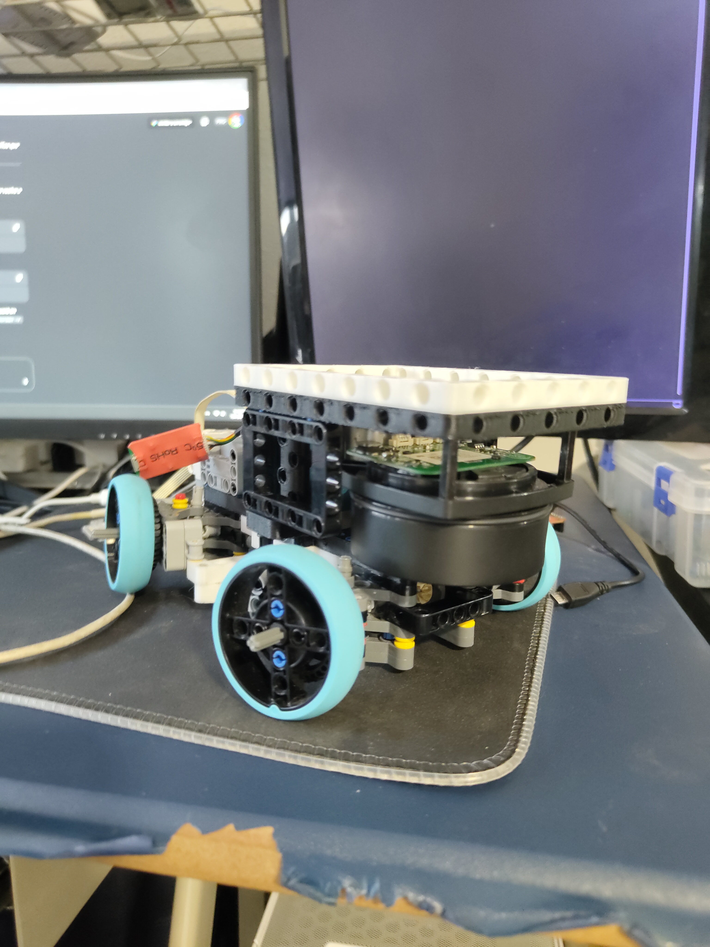
Engineering_Journal/July/IMG_20250724_174622743.jpg
