JRavenelco/WRO_2025_SSbots/Engineering_Journal/July/IMG_20250724_174629655.jpg

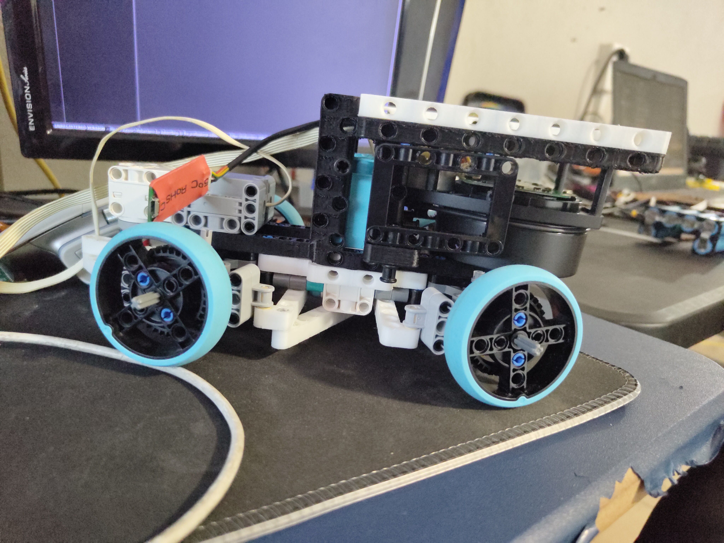
Engineering_Journal/July/IMG_20250724_174629655.jpg
