JRavenelco/WRO_2025_SSbots/Engineering_Journal/July/IMG_20250731_161333665.jpg

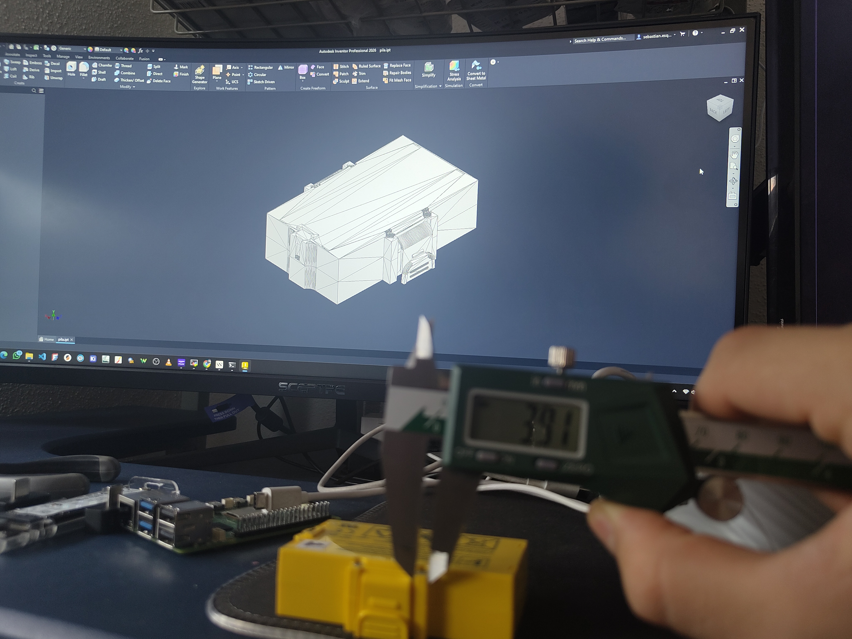
Engineering_Journal/July/IMG_20250731_161333665.jpg
