JRavenelco/WRO_2025_SSbots/Engineering_Journal/July/IMG_20250731_170821362.jpg

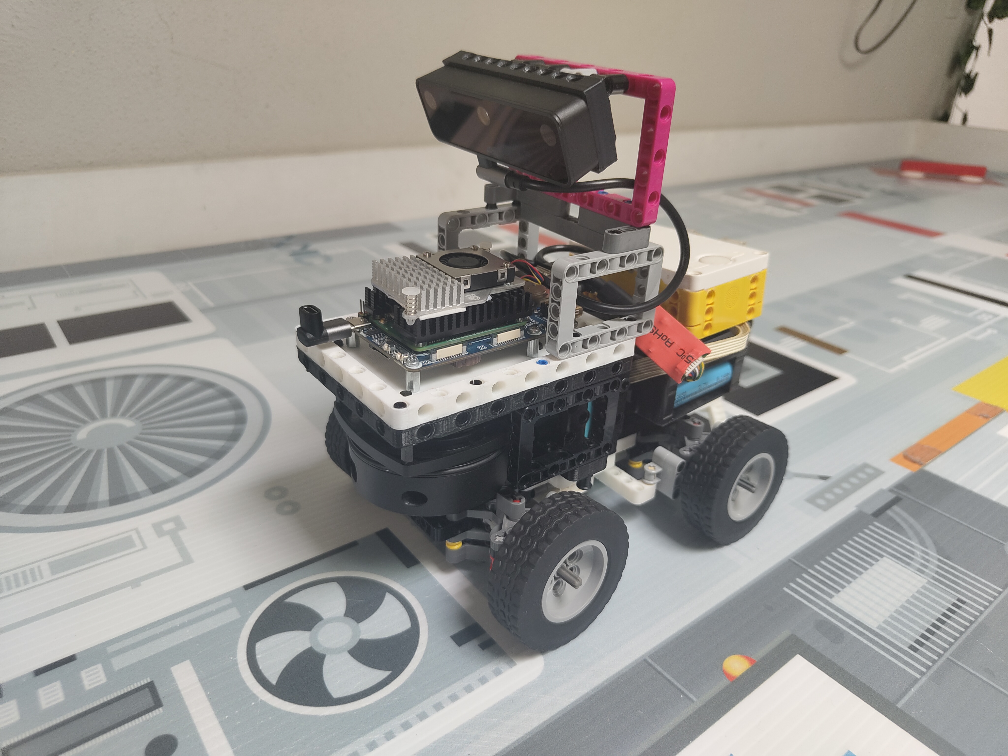
Engineering_Journal/July/IMG_20250731_170821362.jpg
