JRavenelco/WRO_2025_SSbots/Engineering_Journal/July/IMG_20250731_170908695.jpg

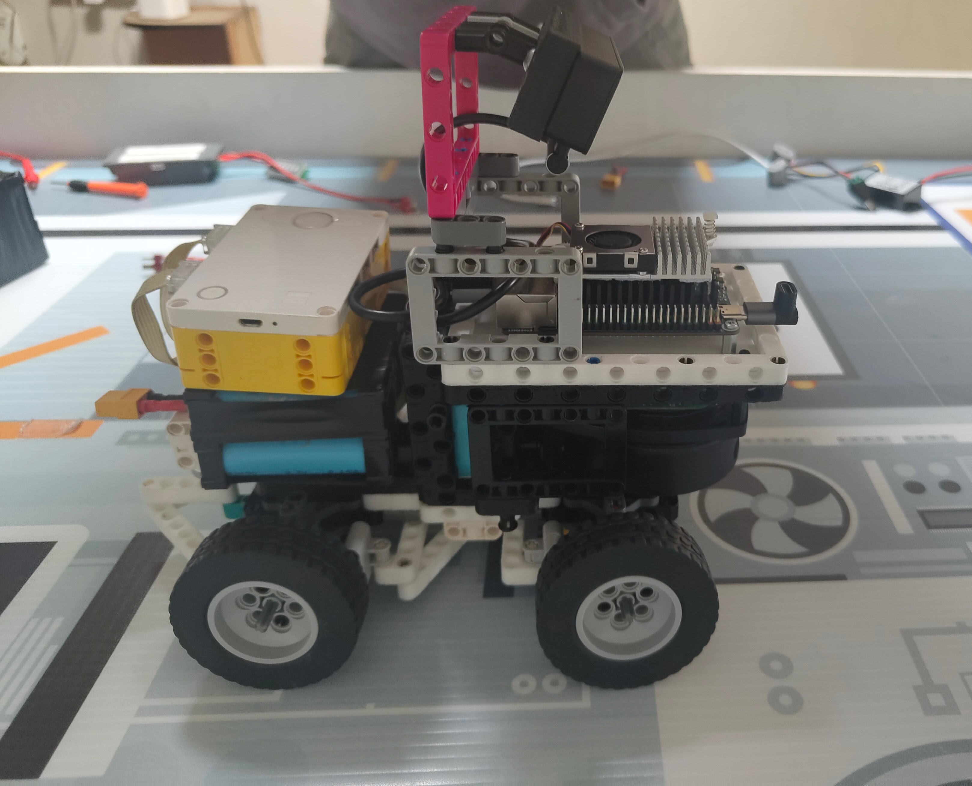
Engineering_Journal/July/IMG_20250731_170908695.jpg
