JRavenelco/WRO_2025_SSbots/Engineering_Journal/September/IMG_20250904_193428120.jpg

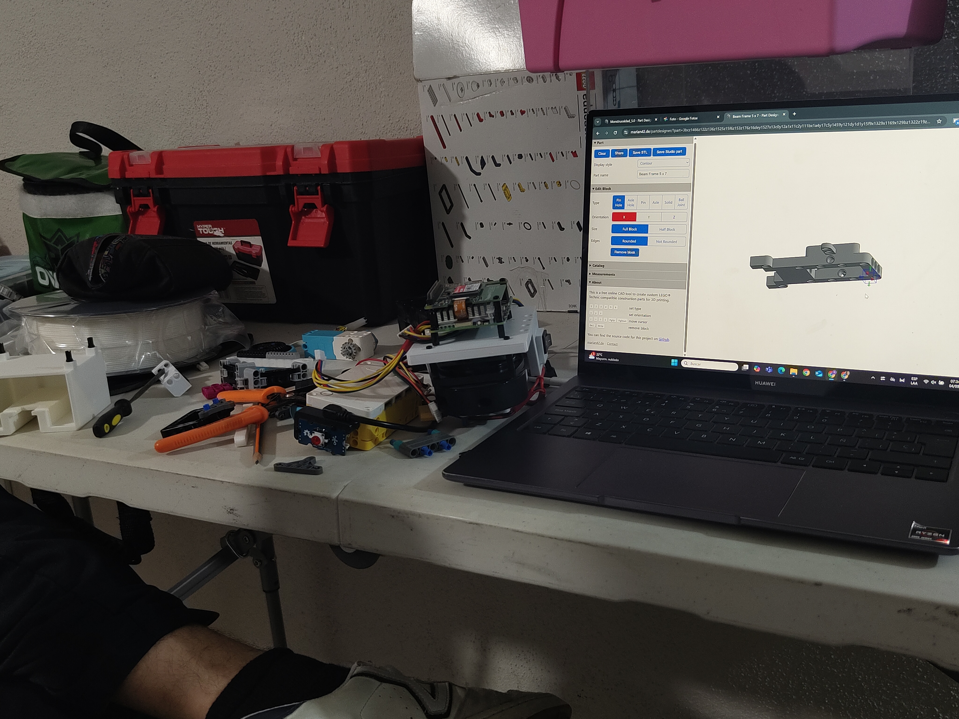
Engineering_Journal/September/IMG_20250904_193428120.jpg
