JRavenelco/WRO_2025_SSbots/Engineering_Journal/September/IMG_20250904_202551347.jpg

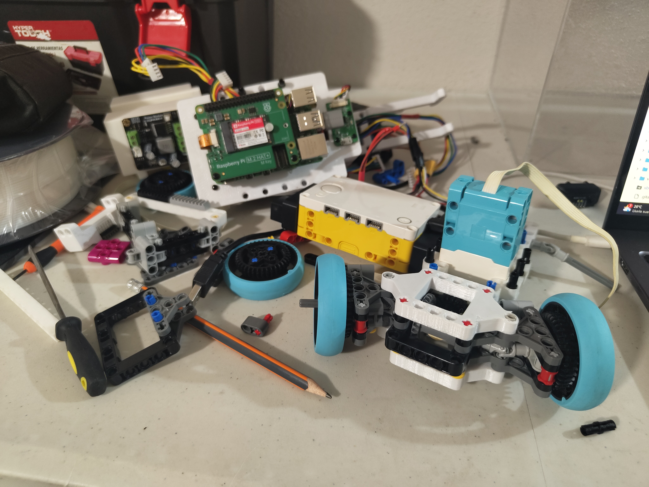
Engineering_Journal/September/IMG_20250904_202551347.jpg
