JRavenelco/WRO_2025_SSbots/Engineering_Journal/September/IMG_20250904_202553581.jpg

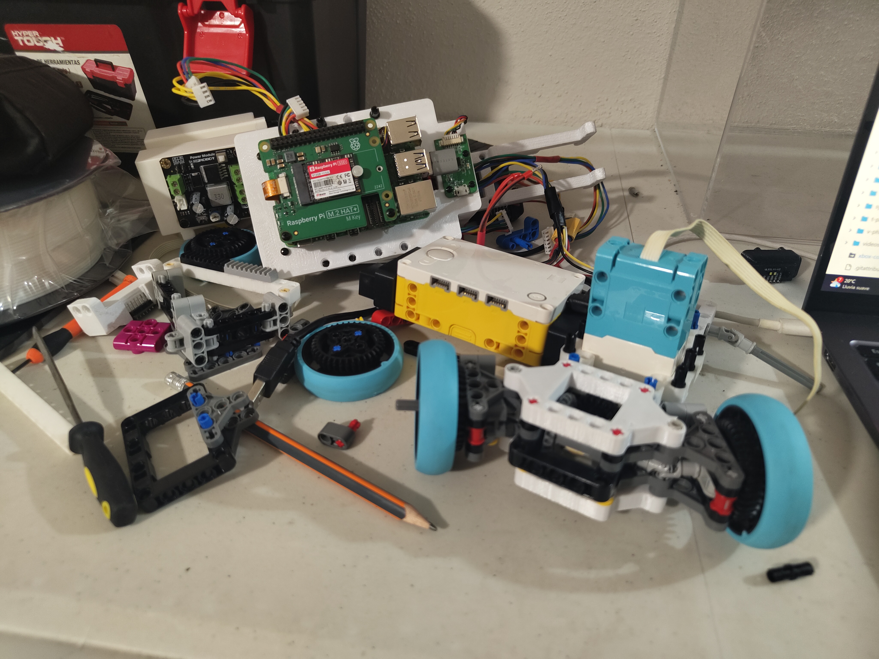
Engineering_Journal/September/IMG_20250904_202553581.jpg
