JRavenelco/WRO_2025_SSbots/Engineering_Journal/September/IMG_20250907_184942313.jpg

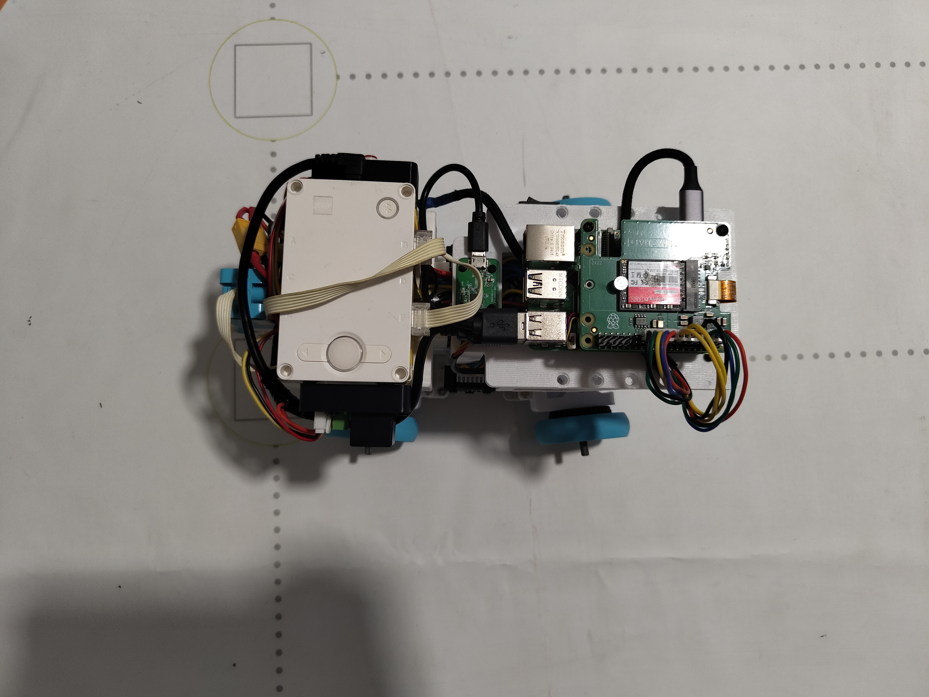
Engineering_Journal/September/IMG_20250907_184942313.jpg
