JRavenelco/WRO_2025_SSbots/Engineering_Journal/September/IMG_20250907_184951360.jpg

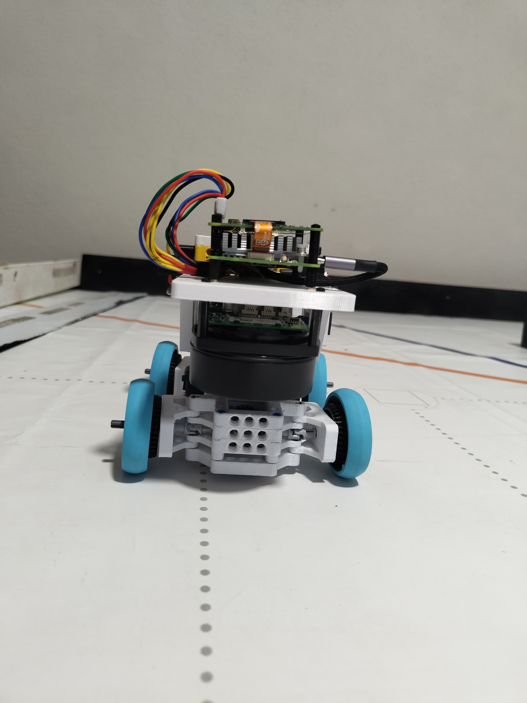
Engineering_Journal/September/IMG_20250907_184951360.jpg
