JRavenelco/WRO_2025_SSbots/Engineering_Journal/September/IMG_20250915_120533071.jpg

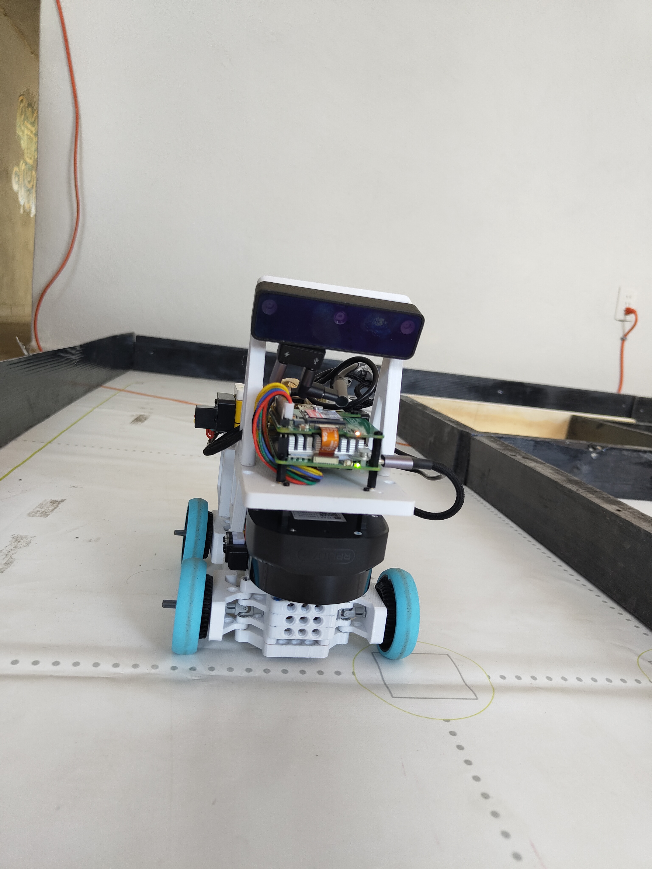
Engineering_Journal/September/IMG_20250915_120533071.jpg
