JRavenelco/WRO_2025_SSbots/other/Power delivery board/power_delivery_board/power_board.pdf

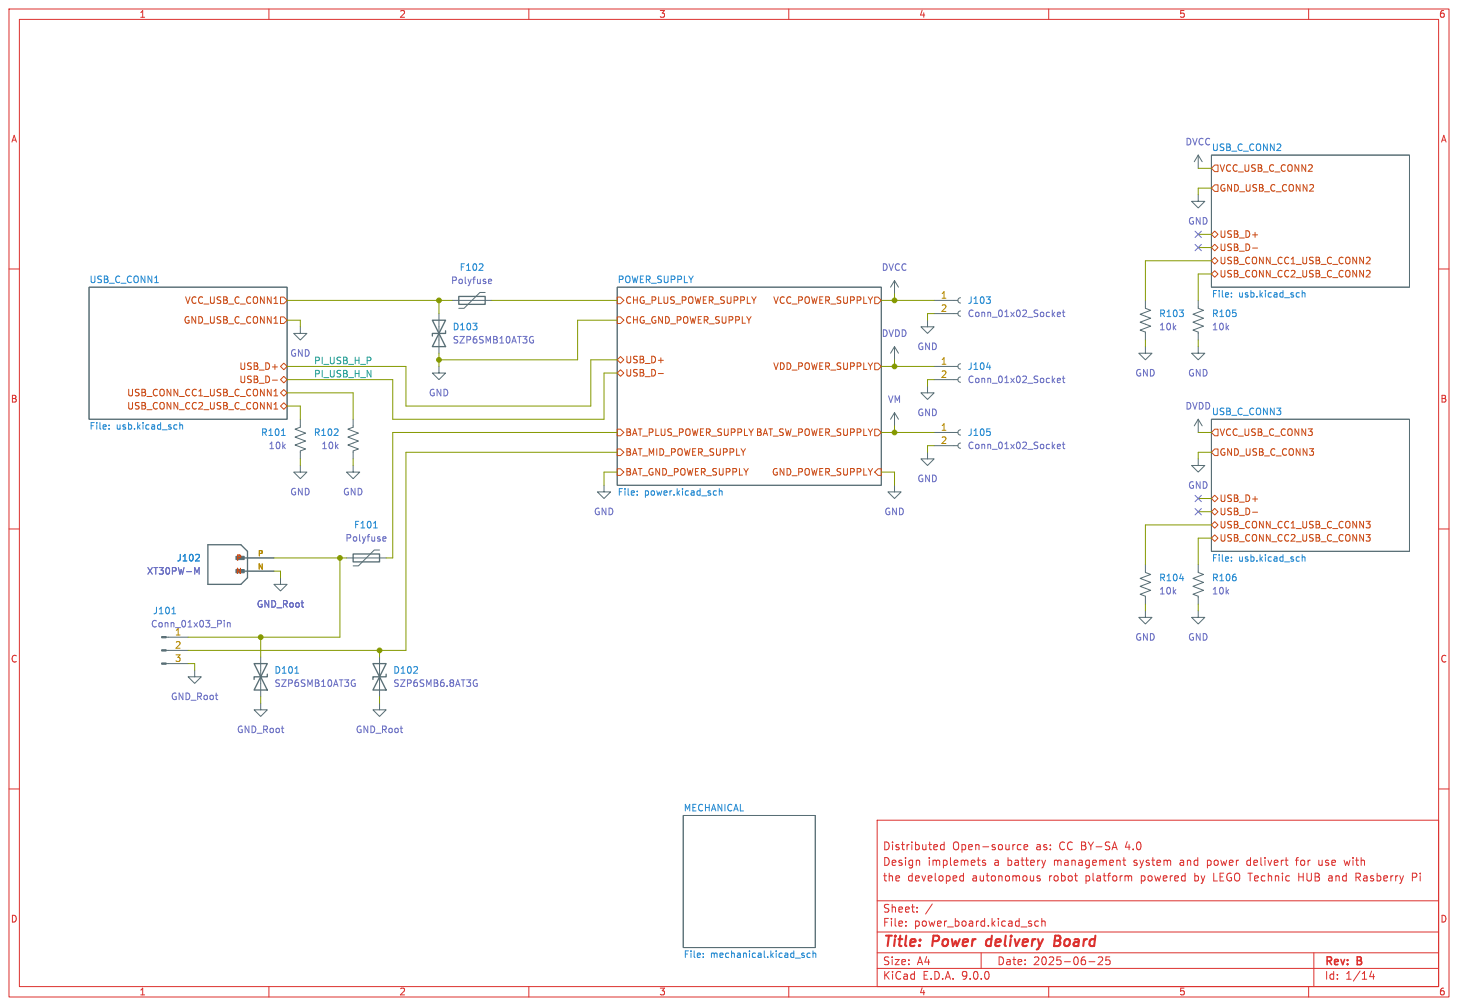
[picture p98: page 1]

File: power_board.kicad_sch Sheet: /
Id: 1/14 Title: Power delivery Board

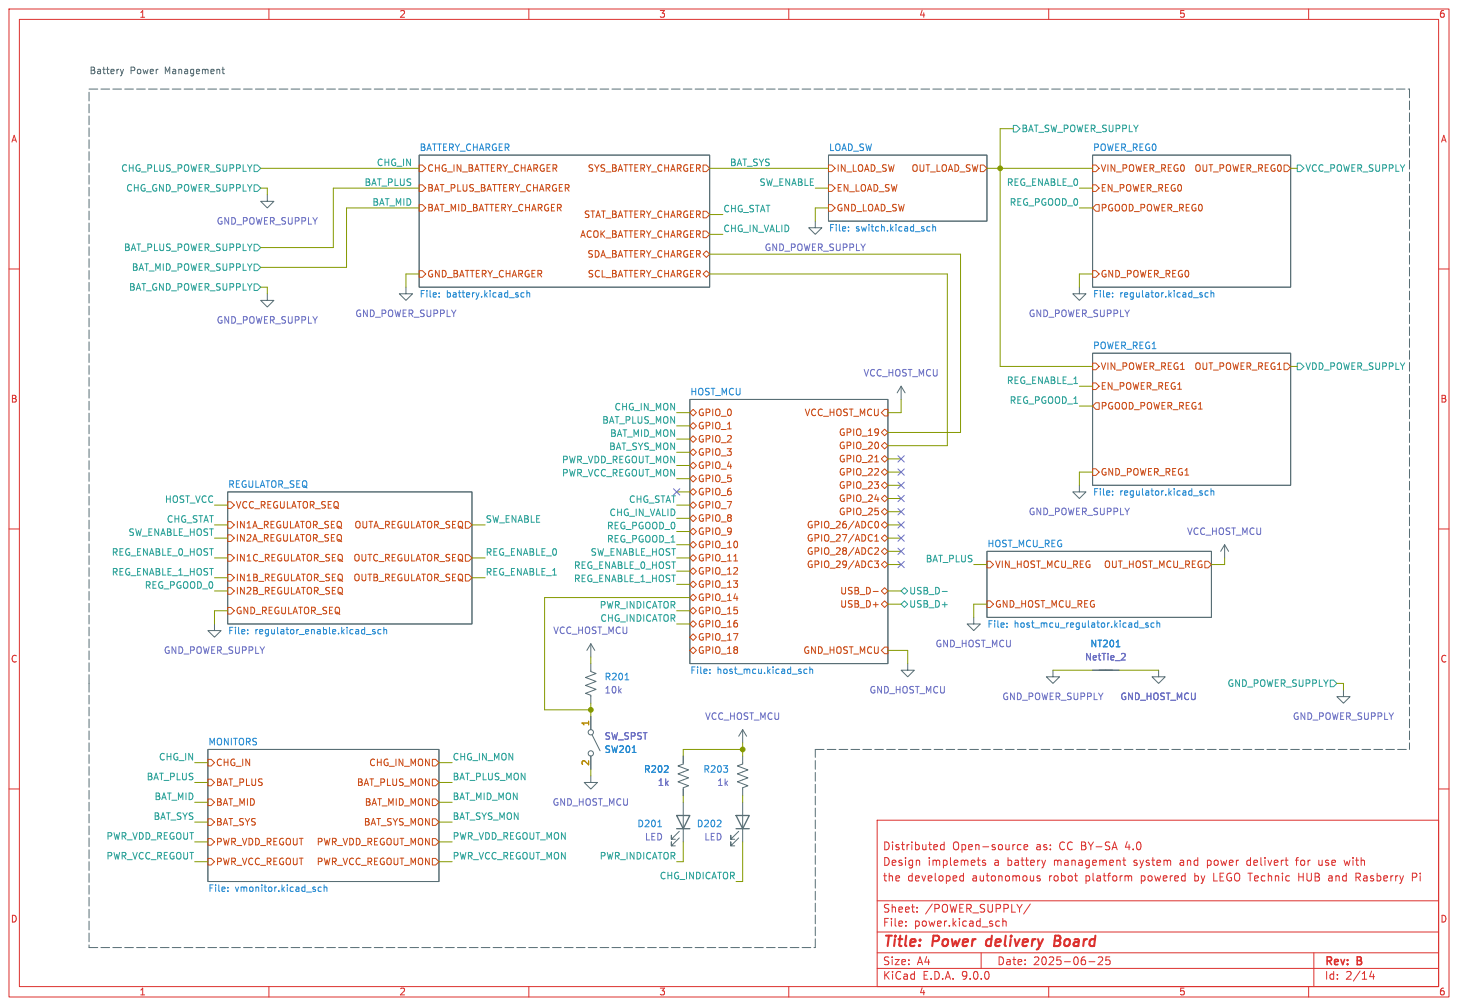
[picture p99: page 2]

File: power.kicad_sch Sheet: /POWER_SUPPLY/
Id: 2/14 Title: Power delivery Board

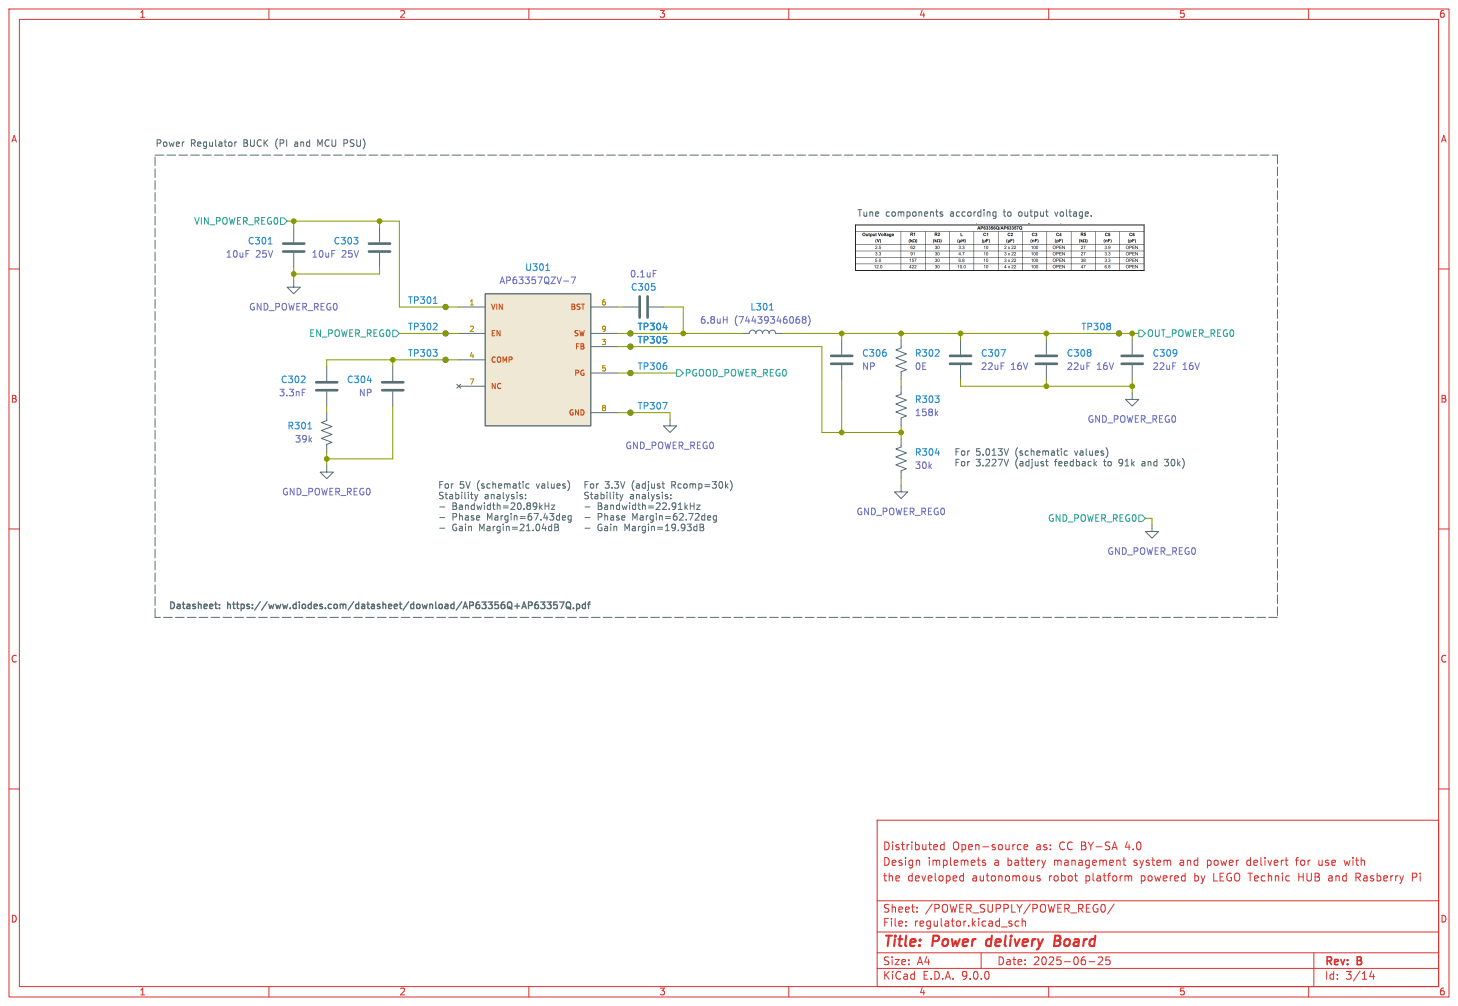
[picture p100: page 3]

File: regulator.kicad_sch Sheet: /POWER_SUPPLY/POWER_REG0/
Id: 3/14 Title: Power delivery Board

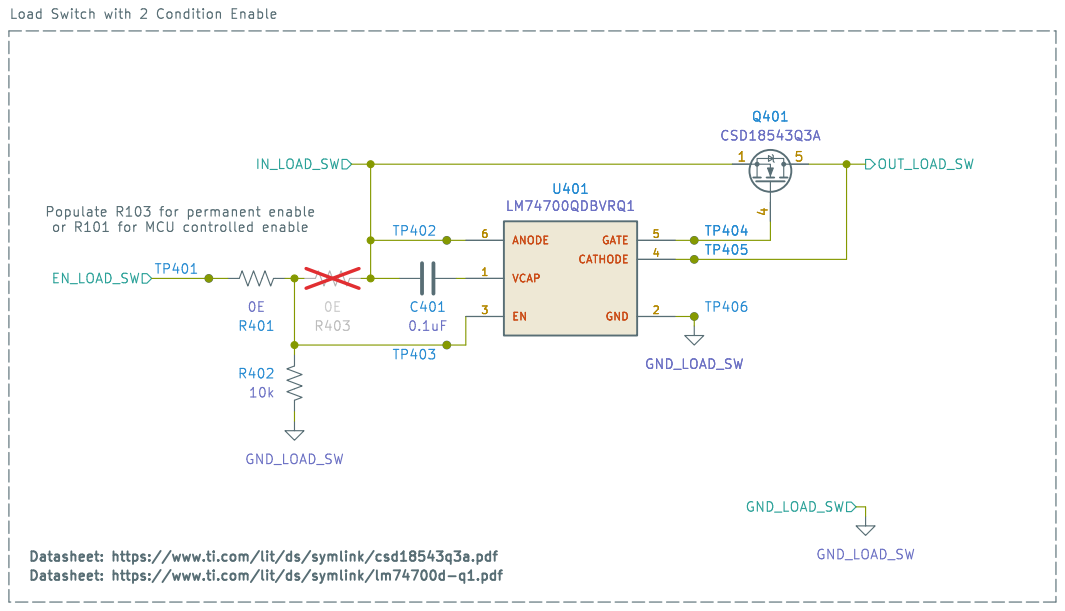
[picture p101: page 4]

Datasheet: https://www.ti.com/lit/ds/symlink/lm74700d-q1.pdf

File: switch.kicad_sch Sheet: /POWER_SUPPLY/LOAD_SW/
Id: 4/14 Title: Power delivery Board

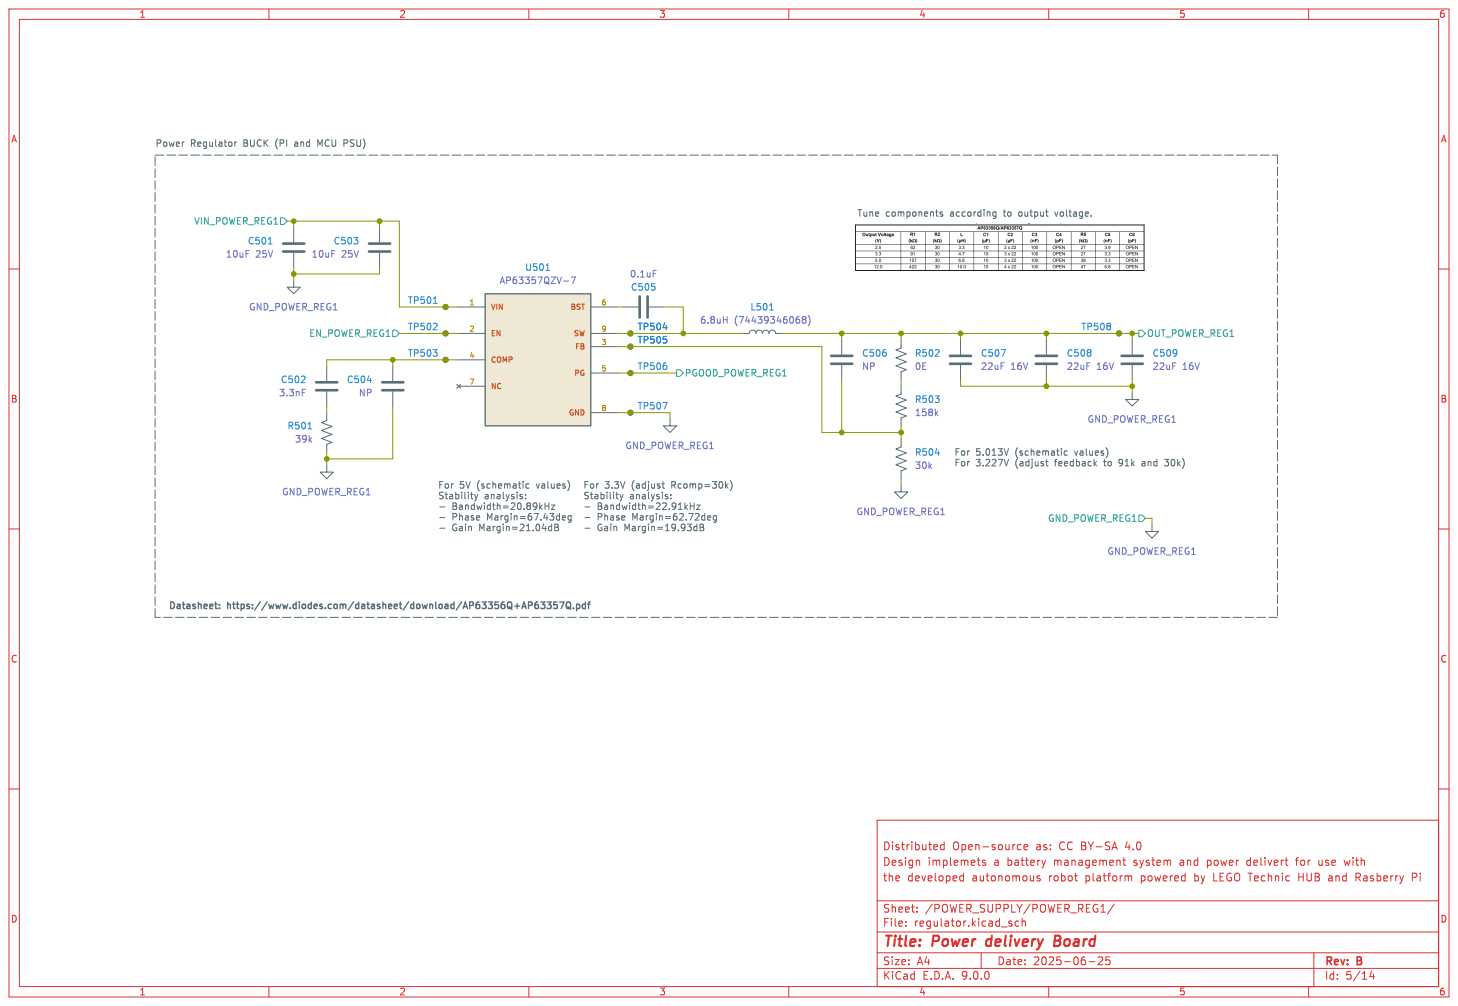
[picture p102: page 5]

File: regulator.kicad_sch Sheet: /POWER_SUPPLY/POWER_REG1/
Id: 5/14 Title: Power delivery Board

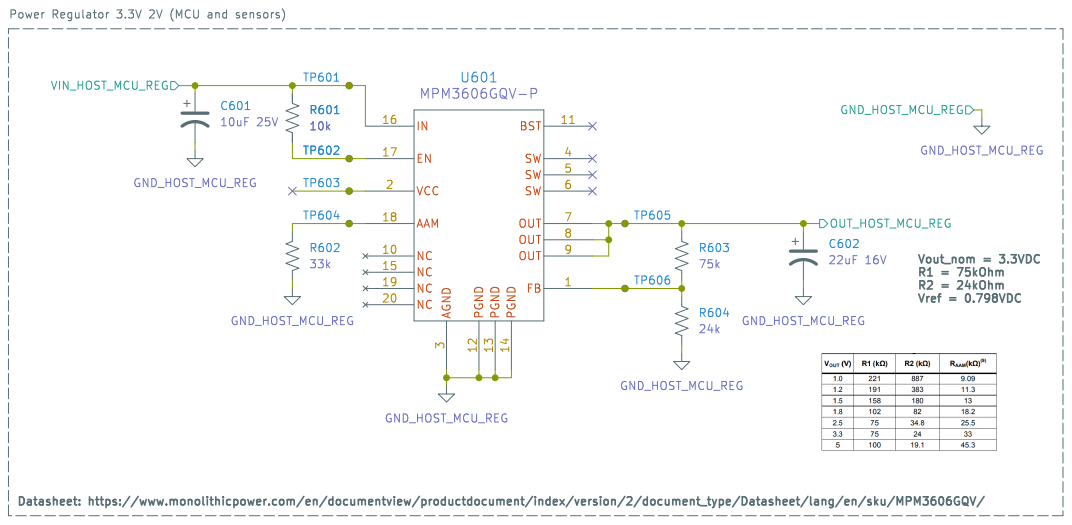
[picture p103: page 6]

3 PGND 12 PGND 13 PGND 14 BST 11 SW 4 SW 5 SW 6 OUT 7 OUT 8 OUT 9 FB 1 U601 MPM3606GQV-P

File: host_mcu_regulator.kicad_sch Sheet: /POWER_SUPPLY/HOST_MCU_REG/
Id: 6/14 Title: Power delivery Board

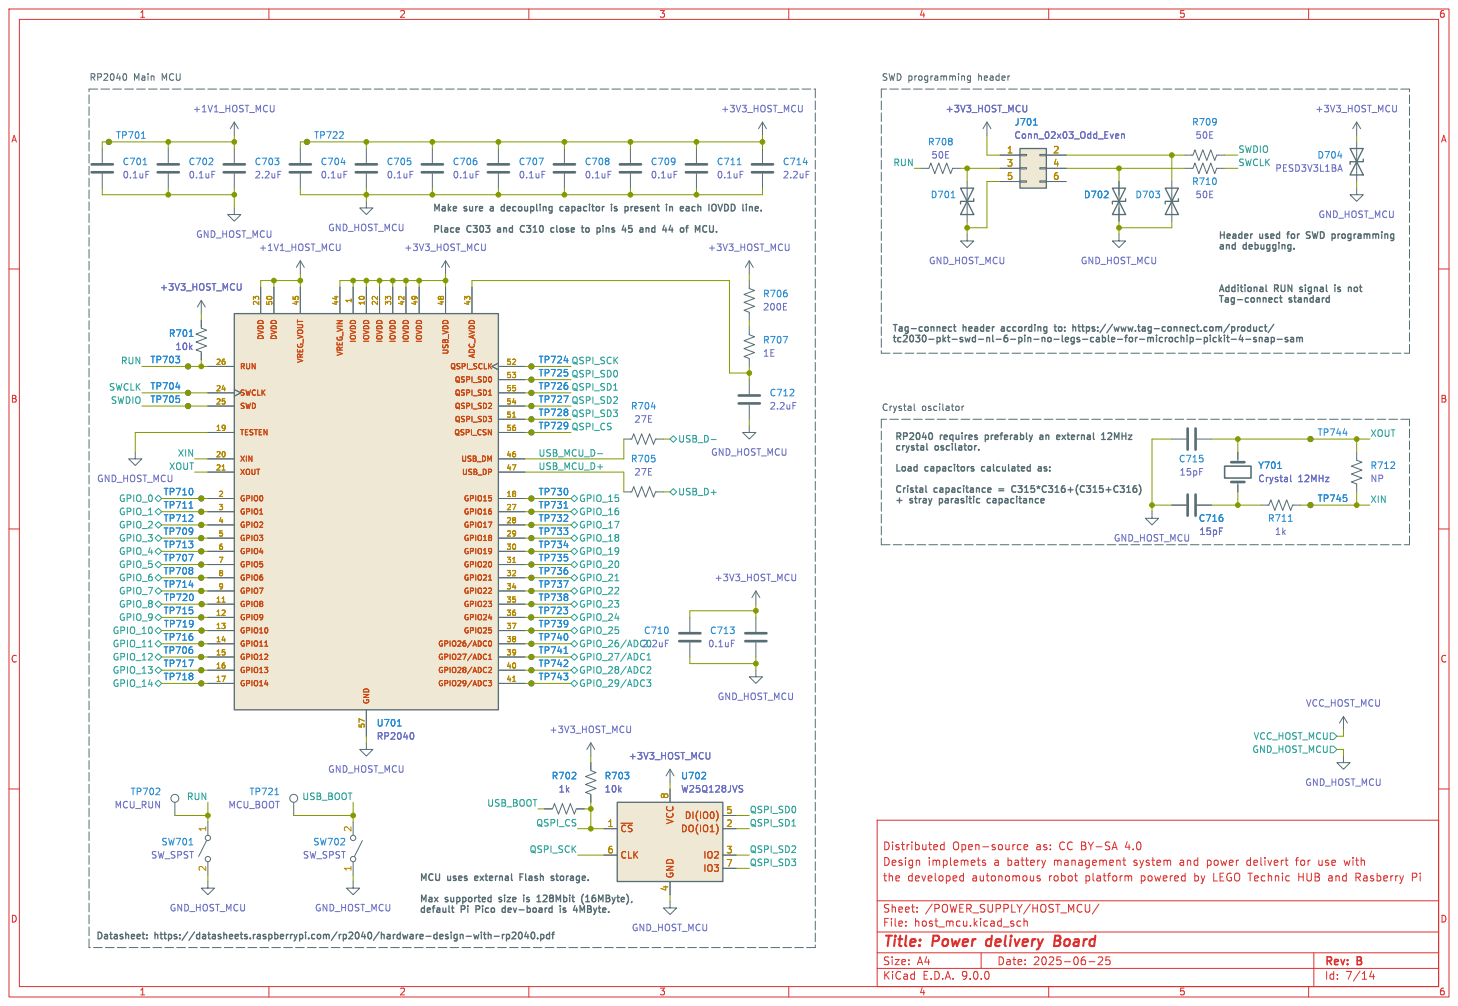
[picture p104: page 7]

1 IOVDD 10 GND 57 IOVDD 22 IOVDD 33 IOVDD 42 IOVDD 49 USB_VDD 48 ADC_AVDD 43 QSPI_SCLK 52 QSPI_SD0 53 QSPI_SD1 55 QSPI_SD2 54 QSPI_SD3 51 QSPI_CSN 56 USB_DM 46 USB_DP 47 GPIO15 18 GPIO16 27 GPIO17 28 GPIO18 29 GPIO19 30 GPIO20 31 GPIO21 32 GPIO22 34 GPIO23 35 GPIO24 36 GPIO25 37 GPIO26/ADC0 38 GPIO27/ADC1 39 GPIO28/ADC2 40 GPIO29/ADC3 41 TP717 TP745 Y701 Crystal 12MHz D702

1 IOVDD 10 GND 57 IOVDD 22 IOVDD 33 IOVDD 42 IOVDD 49 USB_VDD 48 ADC_AVDD 43 QSPI_SCLK 52 QSPI_SD0 53 QSPI_SD1 55 QSPI_SD2 54 QSPI_SD3 51 QSPI_CSN 56 USB_DM 46 USB_DP 47 GPIO15 18 GPIO16 27 GPIO17 28 GPIO18 29 GPIO19 30 GPIO20 31 GPIO21 32 GPIO22 34 GPIO23 35 GPIO24 36 GPIO25 37 GPIO26/ADC0 38 GPIO27/ADC1 39 GPIO28/ADC2 40 GPIO29/ADC3 41 U701 RP2040 TP702 MCU_RUN

tc2030-pkt-swd-nl-6-pin-no-legs-cable-for-microchip-pickit-4-snap-sam

File: host_mcu.kicad_sch Sheet: /POWER_SUPPLY/HOST_MCU/
Id: 7/14 Title: Power delivery Board

Datasheet: https://datasheets.raspberrypi.com/rp2040/hardware-design-with-rp2040.pdf

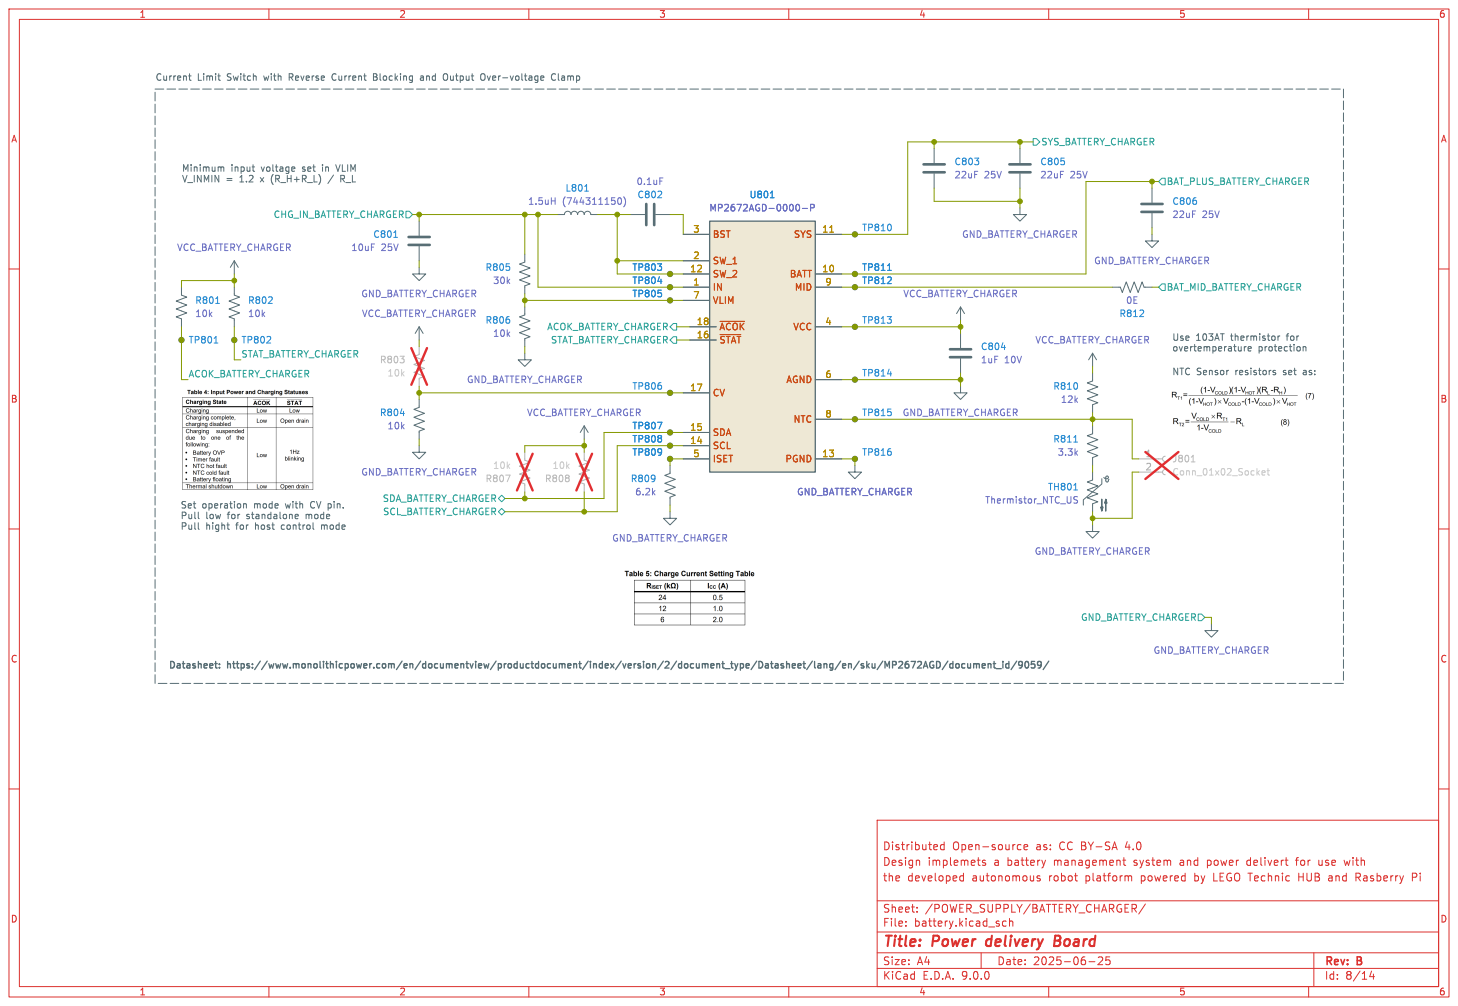
[picture p105: page 8]

File: battery.kicad_sch Sheet: /POWER_SUPPLY/BATTERY_CHARGER/
Id: 8/14 Title: Power delivery Board

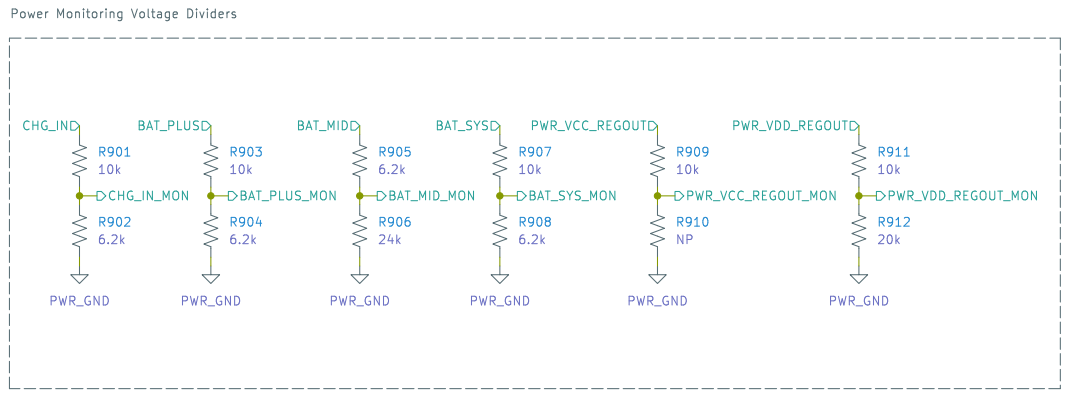
[picture p106: page 9]

File: vmonitor.kicad_sch Sheet: /POWER_SUPPLY/MONITORS/
Id: 9/14 Title: Power delivery Board

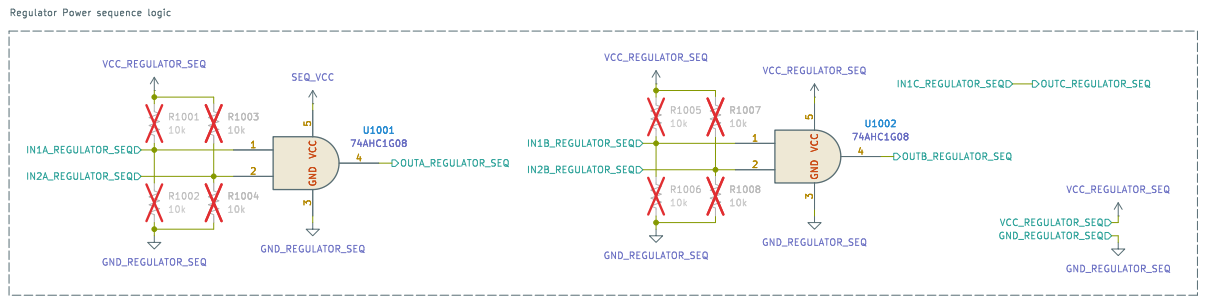
[picture p107: page 10]

File: regulator_enable.kicad_sch Sheet: /POWER_SUPPLY/REGULATOR_SEQ/
Id: 10/14 Title: Power delivery Board

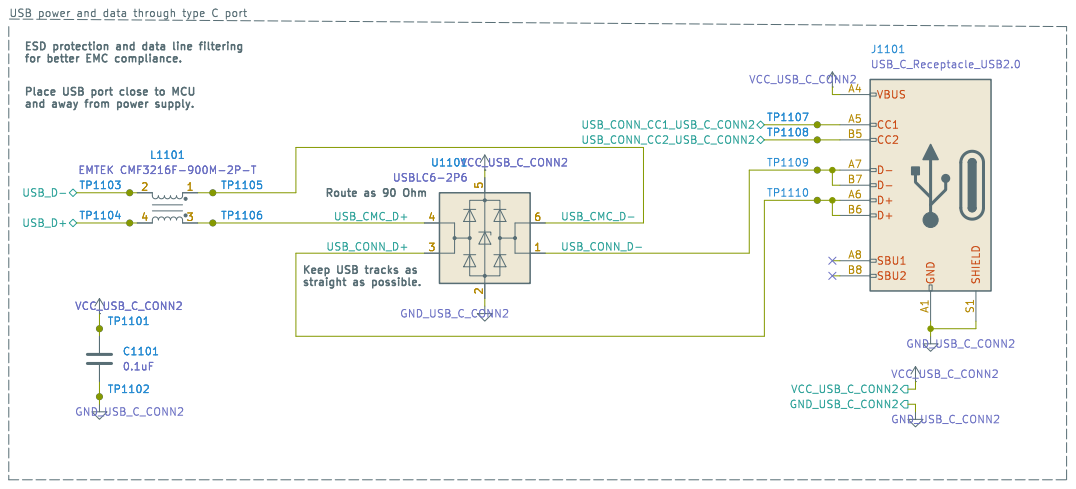
[picture p108: page 11]

straight as possible. ESD protection and data line filtering
for better EMC compliance. Place USB port close to MCU

File: usb.kicad_sch Sheet: /USB_C_CONN2/
Id: 11/14 Title: Power delivery Board

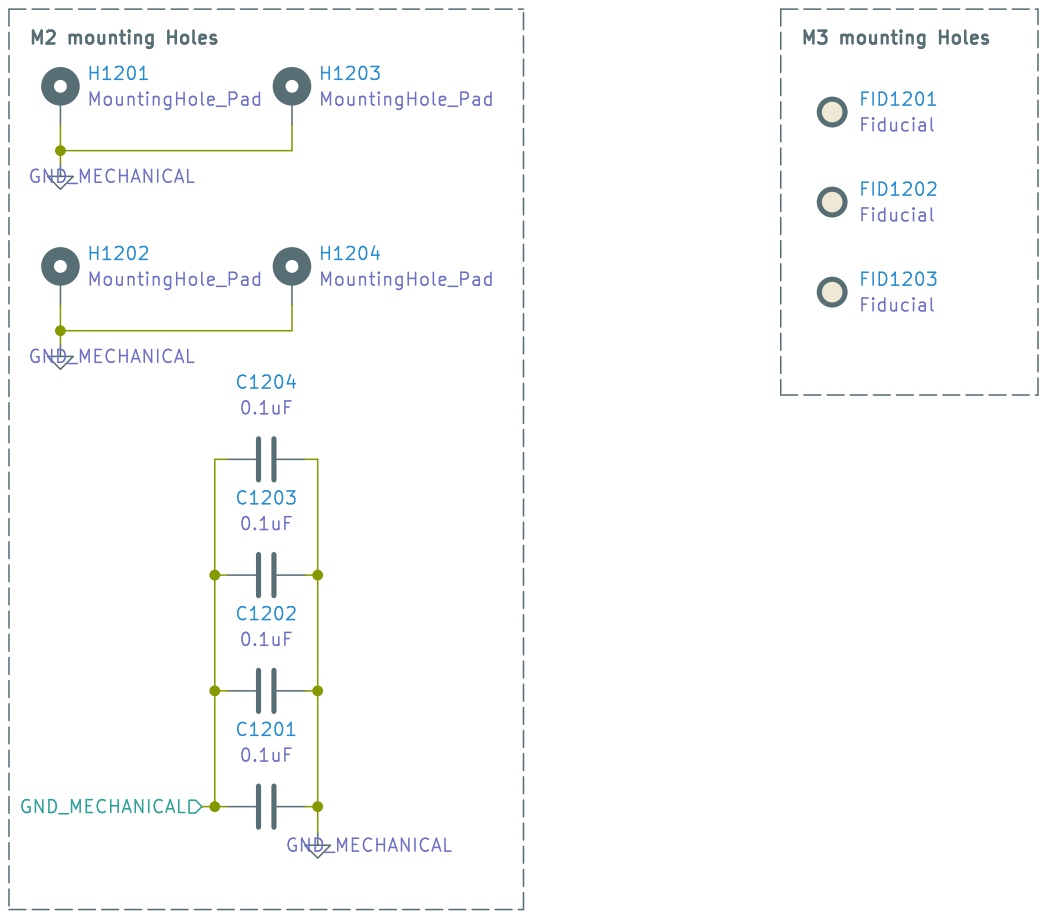
[picture p109: page 12]

File: mechanical.kicad_sch Sheet: /MECHANICAL/
Id: 12/14 Title: Power delivery Board

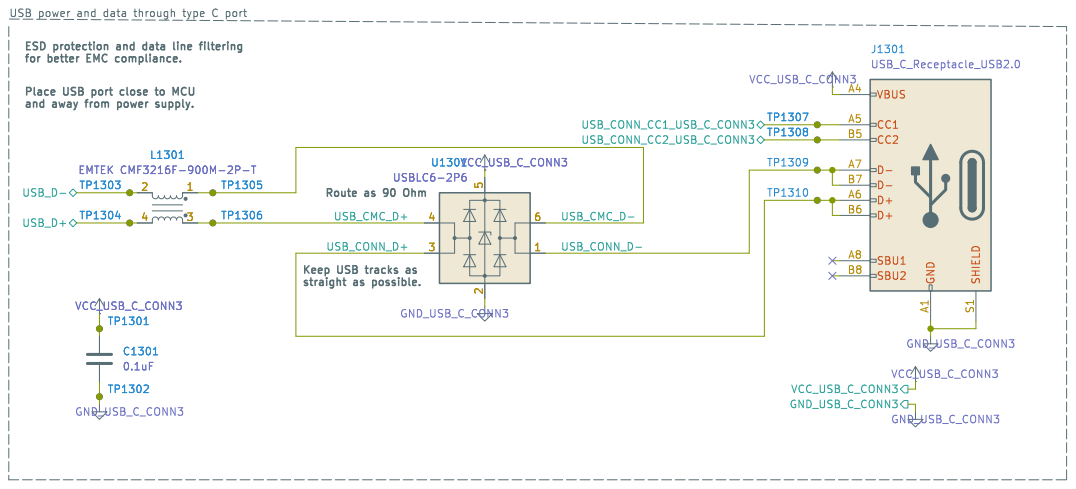
[picture p110: page 13]
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

File: usb.kicad_sch Sheet: /USB_C_CONN3/
Id: 13/14 Title: Power delivery Board

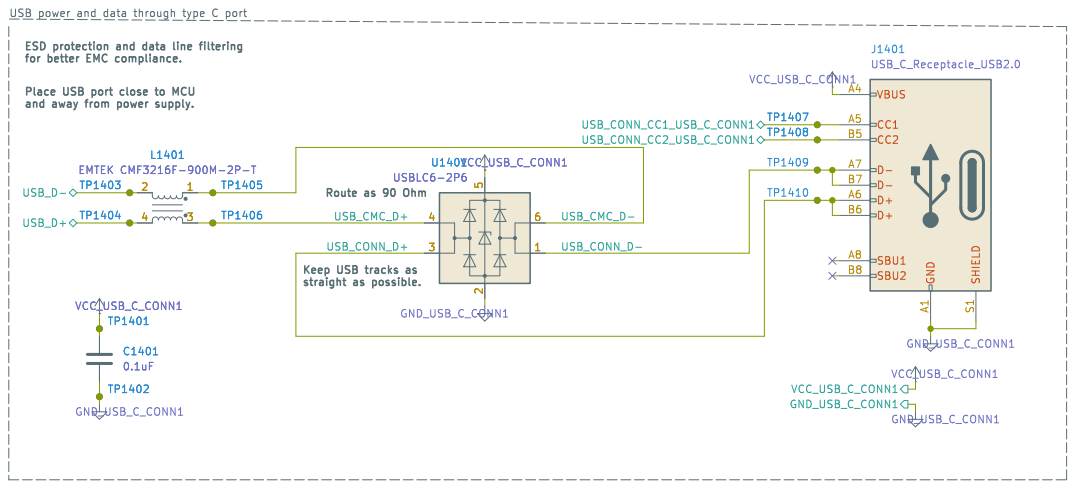
[picture p111: page 14]
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

File: usb.kicad_sch Sheet: /USB_C_CONN1/
Id: 14/14 Title: Power delivery Board
