JRavenelco/WRO_2025_SSbots/other/Power delivery board/power_delivery_board/power_board.kicad_pcb

## KiCad design other/Power delivery board/power_delivery_board/power_board.kicad_pcb (2025-06-27)

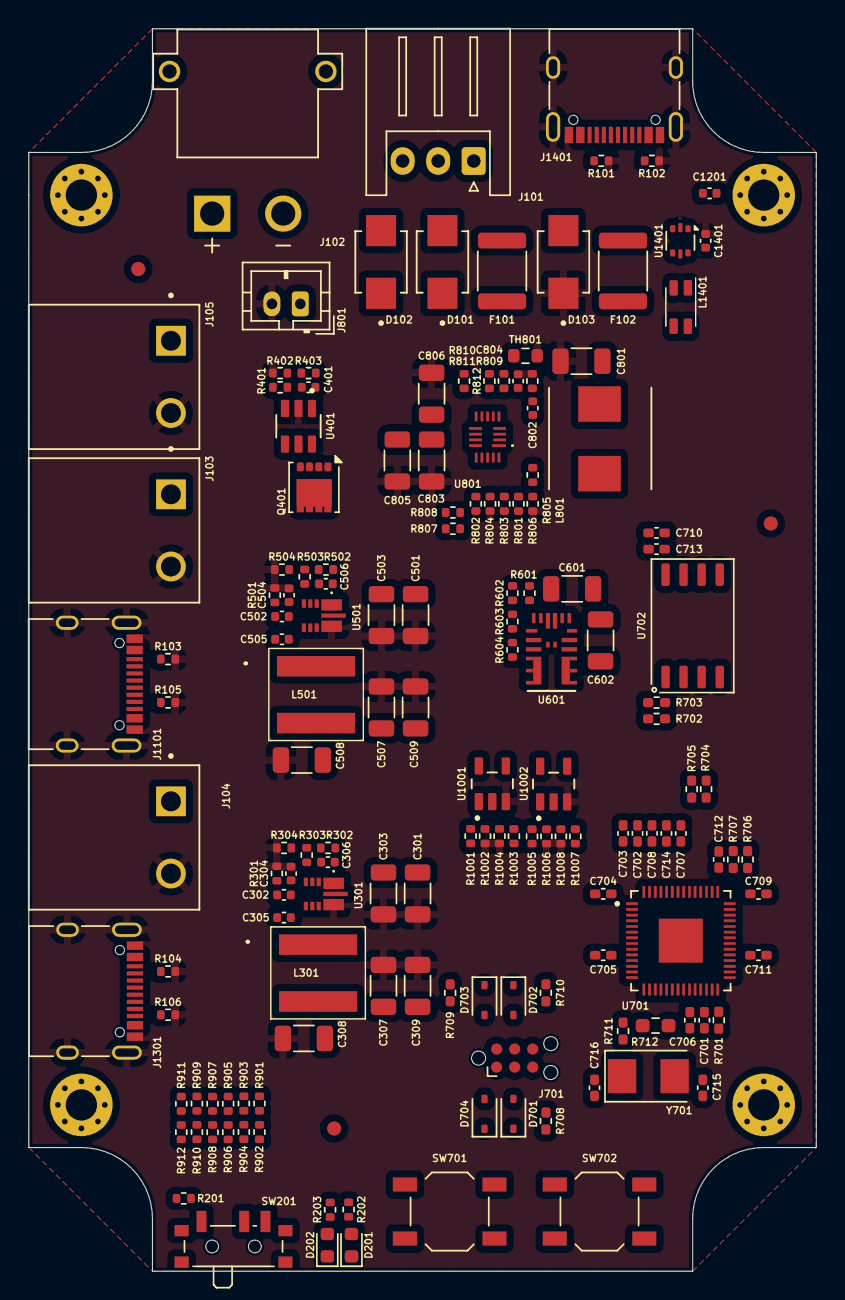
[picture p112: board power_board.kicad_pcb from above]

Board: 4 copper layers, 55.4 x 87.4 mm, 161 parts (0 on the bottom side), 103 nets, no tracks yet.

Parts:
C301, C303, C501, C503, C601, C801: 10uF 25V; C_1206_3216Metric
C302, C502: 3.3nF; C_0402_1005Metric
C304, C306, C504, C506: NP; C_0402_1005Metric
C305, C401, C505, C802, C1201, C1401: 0.1uF; C_0402_1005Metric
C307, C308, C309, C507, C508, C509, C602: 22uF 16V; C_1206_3216Metric
C701, C702, C704, C705, C706, C707, C708, C709, C711, C713: 0.1uF; C_0402_1005Metric_Pad0.74x0.62mm_HandSolder
C703, C710, C712, C714: 2.2uF; C_0402_1005Metric_Pad0.74x0.62mm_HandSolder
C715, C716: 15pF; C_0402_1005Metric_Pad0.74x0.62mm_HandSolder
C803, C805, C806: 22uF 25V; C_1206_3216Metric
C804: 1uF 10V; C_0402_1005Metric
D101, D103: SZP6SMB10AT3G; DIOM4336X265N
D102: SZP6SMB6.8AT3G; DIOM4336X265N
D201, D202: LED; LED_0603_1608Metric
D701, D702, D703, D704: PESD3V3L1BA; D_SOD-323
F101, F102: Polyfuse; Fuse_1812_4532Metric
FID1201, FID1202, FID1203: Fiducial; Fiducial_1mm_Mask2mm
H1201, H1202, H1203, H1204: MountingHole_Pad; MountingHole_2.2mm_M2_Pad_Via
J101: Conn_01x03_Pin; JST_XH_S3B-XH-A_1x03_P2.50mm_Horizontal
J102: XT30PW-M; AMASS_XT30PW-M
J103, J104, J105: Conn_01x02_Socket; PHOENIX_1759017
J701: Conn_02x03_Odd_Even; Tag-Connect_TC2030-IDC-NL_2x03_P1.27mm_Vertical
J801: Conn_01x02_Socket; JST_PH_B2B-PH-K_1x02_P2.00mm_Vertical
J1101, J1301, J1401: USB_C_Receptacle_USB2.0; USB_C_Receptacle_XKB_U262-16XN-4BVC11
L301, L501: 6.8uH (74439346068); 74439346068
L801: 1.5uH (744311150); WE-HCI_7030_7040_705023
L1401: EMTEK CMF3216F-900M-2P-T; L_CommonMode_Wurth_WE-CNSW-1206
Q401: CSD18543Q3A; VSON-8_3.3x3.3mm_P0.65mm_NexFET
R101, R102, R103, R104, R105, R106, R201, R402, R601, R801, R802, R803, R804, R806, R807, R808, R901, R903, R907, R909, R911, R1001, R1002, R1003, R1004, R1005, R1006, R1007, R1008: 10k; R_0402_1005Metric
R202, R203: 1k; R_0402_1005Metric
R301, R501: 39k; R_0402_1005Metric
R302, R401, R403, R502, R812: 0E; R_0402_1005Metric
R303, R503: 158k; R_0402_1005Metric
R304, R504, R805: 30k; R_0402_1005Metric
R602: 33k; R_0402_1005Metric
R603: 75k; R_0402_1005Metric
R604, R906: 24k; R_0402_1005Metric
R701, R703: 10k; R_0402_1005Metric_Pad0.72x0.64mm_HandSolder
R702, R711: 1k; R_0402_1005Metric_Pad0.72x0.64mm_HandSolder
R704, R705: 27E; R_0402_1005Metric_Pad0.72x0.64mm_HandSolder
R706: 200E; R_0402_1005Metric_Pad0.72x0.64mm_HandSolder
R707: 1E; R_0402_1005Metric_Pad0.72x0.64mm_HandSolder
R708, R709, R710: 50E; R_0402_1005Metric_Pad0.72x0.64mm_HandSolder
R712: NP; R_0603_1608Metric_Pad0.98x0.95mm_HandSolder
R809, R902, R904, R905, R908: 6.2k; R_0402_1005Metric
R810: 12k; R_0402_1005Metric
R811: 3.3k; R_0402_1005Metric
R910: NP; R_0402_1005Metric
R912: 20k; R_0402_1005Metric
SW201: SW_SPST; SW_SPDT_PCM12
SW701, SW702: SW_SPST; SW_SPST_TL3342
TH801: Thermistor_NTC_US; R_0603_1608Metric
U301, U501: AP63357QZV-7; CONV_AP63357QZV-7
U401: LM74700QDBVRQ1; SOT95P280X145-6N
U601: MPM3606GQV-P; QFN3p0x5p0x1p6_MPM3606_MNP
U701: RP2040; QFN40P700X700X90-57N
U702: W25Q128JVS; SOIC-8_5.23x5.23mm_P1.27mm
U801: MP2672AGD-0000-P; MP2672AGD0000P
U1001, U1002: 74AHC1G08; SOT95P280X145-5N
U1401: USBLC6-2P6; SOT-666
Y701: Crystal 12MHz; Crystal_SMD_5032-2Pin_5.0x3.2mm

Connections:
+1V1_HOST_MCU: C701.1, C702.1, C703.1, U701.23 (DVDD), U701.45 (VREG_VOUT), U701.50 (DVDD)
+3V3_HOST_MCU: C704.1, C705.1, C706.1, C707.1, C708.1, C709.1, C710.1, C711.1, C713.1, C714.1, D704.2 (A2), J701.1, R701.1, R703.1, R706.1, U701.1 (IOVDD), U701.10 (IOVDD), U701.22 (IOVDD), U701.33 (IOVDD), U701.42 (IOVDD), U701.44 (VREG_VIN), U701.48 (USB_VDD), U701.49 (IOVDD), U702.8 (VCC)
/PI_USB_H_N: L1401.2, R704.2
/PI_USB_H_P: L1401.4, R705.2
/POWER_SUPPLY/BATTERY_CHARGER/SCL_BATTERY_CHARGER: R808.1, U701.31 (GPIO20), U801.14 (SCL)
/POWER_SUPPLY/BATTERY_CHARGER/SDA_BATTERY_CHARGER: R807.1, U701.30 (GPIO19), U801.15 (SDA)
/POWER_SUPPLY/BAT_MID: D102.2 (A2), J101.2, R812.1, R905.1
/POWER_SUPPLY/BAT_MID_MON: R905.2, R906.1, U701.4 (GPIO2)
/POWER_SUPPLY/BAT_PLUS: C601.1, C806.1, F101.2, R601.1, R903.1, U601.16 (IN), U801.10 (BATT)
/POWER_SUPPLY/BAT_PLUS_MON: R903.2, R904.1, U701.3 (GPIO1)
/POWER_SUPPLY/BAT_SYS: C401.1, C803.1, C805.1, Q401.1 (S), Q401.2 (S), Q401.3 (S), R403.1, R907.1, U401.6 (ANODE), U801.11 (SYS)
/POWER_SUPPLY/BAT_SYS_MON: R907.2, R908.1, U701.5 (GPIO3)
/POWER_SUPPLY/CHG_IN: C801.1, F102.2, L801.1, R805.1, R901.1, U801.1 (IN)
/POWER_SUPPLY/CHG_INDICATOR: D202.1 (K), U701.27 (GPIO16)
/POWER_SUPPLY/CHG_IN_MON: R901.2, R902.1, U701.2 (GPIO0)
/POWER_SUPPLY/CHG_IN_VALID: R801.2, U701.11 (GPIO8), U801.18 (~ACOK)
/POWER_SUPPLY/CHG_STAT: R802.2, R1001.2, R1002.1, U701.9 (GPIO7), U801.16 (~STAT), U1001.1
/POWER_SUPPLY/HOST_MCU/GPIO_14: R201.2, SW201.1 (A), U701.17 (GPIO14)
/POWER_SUPPLY/HOST_MCU/QSPI_CS: R702.2, R703.2, U701.56 (QSPI_CSN), U702.1 (~CS)
/POWER_SUPPLY/HOST_MCU/QSPI_SCK: U701.52 (QSPI_SCLK), U702.6 (CLK)
/POWER_SUPPLY/HOST_MCU/QSPI_SD0: U701.53 (QSPI_SD0), U702.5 (DI(IO0))
/POWER_SUPPLY/HOST_MCU/QSPI_SD1: U701.55 (QSPI_SD1), U702.2 (DO(IO1))
/POWER_SUPPLY/HOST_MCU/QSPI_SD2: U701.54 (QSPI_SD2), U702.3 (IO2)
/POWER_SUPPLY/HOST_MCU/QSPI_SD3: U701.51 (QSPI_SD3), U702.7 (IO3)
/POWER_SUPPLY/HOST_MCU/RUN: R701.2, R708.1, SW701.1 (A), U701.26 (RUN)
/POWER_SUPPLY/HOST_MCU/SWCLK: R710.2, U701.24 (SWCLK)
/POWER_SUPPLY/HOST_MCU/SWDIO: R709.2, U701.25 (SWD)
/POWER_SUPPLY/HOST_MCU/USB_BOOT: R702.1, SW702.2 (B)
/POWER_SUPPLY/HOST_MCU/USB_MCU_D+: R705.1, U701.47 (USB_DP)
/POWER_SUPPLY/HOST_MCU/USB_MCU_D-: R704.1, U701.46 (USB_DM)
/POWER_SUPPLY/HOST_MCU/XIN: R711.2, R712.1, U701.20 (XIN)
/POWER_SUPPLY/HOST_MCU/XOUT: C715.2, R712.2, U701.21 (XOUT), Y701.2
/POWER_SUPPLY/PWR_INDICATOR: D201.1 (K), U701.18 (GPIO15)
/POWER_SUPPLY/PWR_VCC_REGOUT_MON: R909.2, R910.1, U701.7 (GPIO5)
/POWER_SUPPLY/PWR_VDD_REGOUT_MON: R911.2, R912.1, U701.6 (GPIO4)
/POWER_SUPPLY/REG_ENABLE_0: U301.2 (EN), U701.15 (GPIO12)
/POWER_SUPPLY/REG_ENABLE_1: U501.2 (EN), U1002.4
/POWER_SUPPLY/REG_ENABLE_1_HOST: R1005.2, R1006.1, U701.16 (GPIO13), U1002.1
/POWER_SUPPLY/REG_PGOOD_0: R1007.2, R1008.1, U301.5 (PG), U701.12 (GPIO9), U1002.2
/POWER_SUPPLY/REG_PGOOD_1: U501.5 (PG), U701.13 (GPIO10)
/POWER_SUPPLY/SW_ENABLE: R401.2, U1001.4
/POWER_SUPPLY/SW_ENABLE_HOST: R1003.2, R1004.1, U701.14 (GPIO11), U1001.2
/USB_C_CONN1/USB_CMC_D+: L1401.3, U1401.4 (I/O2)
/USB_C_CONN1/USB_CMC_D-: L1401.1, U1401.6 (I/O1)
/USB_C_CONN1/USB_CONN_CC1_USB_C_CONN1: J1401.A5 (CC1), R102.1
/USB_C_CONN1/USB_CONN_CC2_USB_C_CONN1: J1401.B5 (CC2), R101.1
/USB_C_CONN1/USB_CONN_D+: J1401.A6 (D+), J1401.B6 (D+), U1401.3 (I/O2)
/USB_C_CONN1/USB_CONN_D-: J1401.A7 (D-), J1401.B7 (D-), U1401.1 (I/O1)
/USB_C_CONN2/USB_CONN_CC1_USB_C_CONN2: J1101.A5 (CC1), R103.1
/USB_C_CONN2/USB_CONN_CC2_USB_C_CONN2: J1101.B5 (CC2), R105.1
/USB_C_CONN2/USB_CONN_D+: J1101.A6 (D+), J1101.B6 (D+)
/USB_C_CONN2/USB_CONN_D-: J1101.A7 (D-), J1101.B7 (D-)
/USB_C_CONN3/USB_CONN_CC1_USB_C_CONN3: J1301.A5 (CC1), R104.1
/USB_C_CONN3/USB_CONN_CC2_USB_C_CONN3: J1301.B5 (CC2), R106.1
/USB_C_CONN3/USB_CONN_D+: J1301.A6 (D+), J1301.B6 (D+)
/USB_C_CONN3/USB_CONN_D-: J1301.A7 (D-), J1301.B7 (D-)
DVCC: C306.1, C307.1, C308.1, C309.1, J103.1, J1101.A4 (VBUS), J1101.A9 (VBUS), J1101.B4 (VBUS), J1101.B9 (VBUS), L301.2, R302.1
DVDD: C506.1, C507.1, C508.1, C509.1, J104.1, J1301.A4 (VBUS), J1301.A9 (VBUS), J1301.B4 (VBUS), J1301.B9 (VBUS), L501.2, R502.1
GND: C301.2, C303.2, C304.2, C307.2, C308.2, C309.2, C501.2, C503.2, C504.2, C507.2, C508.2, C509.2, C801.2, C803.2, C804.2, C805.2, C806.2, C1401.2, D103.1 (A1), J103.2, J104.2, J105.2, J801.2, J1101.A1 (GND), J1101.A12 (GND), J1101.B1 (GND), J1101.B12 (GND), J1101.S1 (SHIELD), J1301.A1 (GND), J1301.A12 (GND), J1301.B1 (GND), J1301.B12 (GND), J1301.S1 (SHIELD), J1401.A1 (GND), J1401.A12 (GND), J1401.B1 (GND), J1401.B12 (GND), J1401.S1 (SHIELD), R101.2, R102.2, R103.2, R104.2, R105.2, R106.2, R301.2, R304.2, R402.2, R501.2, R504.2, R804.2, R806.2, R809.2, R1002.2, R1004.2, R1006.2, R1008.2, TH801.2, U301.8 (GND), U401.2 (GND), U501.8 (GND), U801.6 (AGND), U801.13 (PGND), U1001.3 (GND), U1002.3 (GND), U1401.2 (GND)
GND_HOST_MCU: C601.2, C602.2, C701.2, C702.2, C703.2, C704.2, C705.2, C706.2, C707.2, C708.2, C709.2, C710.2, C711.2, C712.2, C713.2, C714.2, C715.1, C716.1, D701.1 (A1), D702.1 (A1), D703.1 (A1), D704.1 (A1), J701.5, R602.2, R604.2, SW201.2 (B), SW701.2 (B), SW702.1 (A), U601.3 (AGND), U601.12 (PGND), U601.13 (PGND), U601.14 (PGND), U701.19 (TESTEN), U701.57 (GND), U702.4 (GND)
GND_MECHANICAL: C1201.1, C1201.2, H1201.1, H1202.1, H1203.1, H1204.1
GND_Root: D101.1 (A1), D102.1 (A1), J101.3, J102.N
unnamed: C302.2, R301.1
unnamed: C502.2, R501.1
unnamed: C716.2, R711.1, Y701.1
unnamed: D101.2 (A2), F101.1, J101.1, J102.P
unnamed: D201.2 (A), R202.2
unnamed: D202.2 (A), R203.2
unnamed: D701.2 (A2), J701.3, R708.2
unnamed: D702.2 (A2), J701.4, R710.1
unnamed: D703.2 (A2), J701.2, R709.1
unnamed: J801.1, R810.2, R811.1, U801.8 (NTC)
unnamed: Q401.4 (G), U401.5 (GATE)
unnamed: R302.2, R303.1
unnamed: R502.2, R503.1
unnamed: R706.2, R707.1
unnamed: R811.2, TH801.1
unnamed: C305.1, U301.6 (BST)
unnamed: C302.1, C304.1, U301.4 (COMP)
unnamed: C306.2, R303.2, R304.1, U301.3 (FB)
unnamed: C305.2, L301.1, U301.9 (SW)
unnamed: R401.1, R402.1, R403.2, U401.3 (EN)
unnamed: C401.2, U401.1 (VCAP)
unnamed: C505.1, U501.6 (BST)
unnamed: C502.1, C504.1, U501.4 (COMP)
unnamed: C506.2, R503.2, R504.1, U501.3 (FB)
unnamed: C505.2, L501.1, U501.9 (SW)
unnamed: R602.1, U601.18 (AAM)
unnamed: R601.2, U601.17 (EN)
unnamed: R603.2, R604.1, U601.1 (FB)
unnamed: C712.1, R707.2, U701.43 (ADC_AVDD)
unnamed: C802.2, U801.3 (BST)
unnamed: R803.2, R804.1, U801.17 (CV)
unnamed: R809.1, U801.5 (ISET)
unnamed: R812.2, U801.9 (MID)
unnamed: C802.1, L801.2, U801.2 (SW_1), U801.12 (SW_2)
unnamed: R805.2, R806.1, U801.7 (VLIM)
PWR_GND: R902.2, R904.2, R906.2, R908.2, R910.2, R912.2
VCC_BATTERY_CHARGER: C804.1, R801.1, R802.1, R803.1, R807.2, R808.2, R810.1, U801.4 (VCC)
VCC_HOST_MCU: C602.1, R201.1, R202.1, R203.1, R603.1, U601.7 (OUT), U601.8 (OUT), U601.9 (OUT)
VCC_REGULATOR_SEQ: R1001.1, R1003.1, R1005.1, R1007.1, U1002.5 (VCC)
VCC_USB_C_CONN1: C1401.1, D103.2 (A2), F102.1, J1401.A4 (VBUS), J1401.A9 (VBUS), J1401.B4 (VBUS), J1401.B9 (VBUS), U1401.5 (VBUS)
VM: C301.1, C303.1, C501.1, C503.1, J105.1, Q401.5 (D), U301.1 (VIN), U401.4 (CATHODE), U501.1 (VIN)
