JRavenelco/WRO_2025_SSbots/(commit log)

2025-05-04 Add fan control script and systemd service
2025-06-07 Backup Jetson Nano previo a migrar a Raspberry Pi 5
2025-06-20 New base script that only turns around the track
    Now with the screen startup already integrated, but does not follow the wall with ultrasonic sensor yet.
2025-06-21 Minor adjustments (removed resetGyro() after every turn)
    [base_SSbots.py]
2025-06-22 Display OLED para mostrar la SSID y la IP
2025-06-23 Script to take pictures with OAK-D Lite camera, which will later be used for model training
2025-06-23 Modified script to use max resolution possible with the OAK camera (13 MP 4208x3120)
2025-06-27 Added models directory
    [OAK camera mount.stl]
2025-06-27 Added Power delivery Board design files
    [battery.kicad_sch, host_mcu.kicad_sch, host_mcu_regulator.kicad_sch, mechanical.kicad_sch, power.kicad_sch, power_board.csv, power_board.kicad_pcb, power_board.kicad_sch]
2025-07-31 Add files via upload
    July 9th: This day we tried implementing two-speed automatic gearbox for more torque at first and then more speed, then temporarily removed due to complications (might improve it and use it later).
