JRavenelco/WRO_2025_SSbots/(notices)

Notices in the files:
other/Power delivery board/power_delivery_board/regulator.kicad_sch:
Distributed Open-source as: CC BY-SA 4.0
